ricsne2010/bobcat-dash/breakout-board/docs/mounting-template.pdf

# BREAKOUT BOARD DRILLING TEMPLATE - FULL SIZE 1:1

Print on US Letter at "Actual size" / 100 % (NOT "Fit", "Shrink oversized pages" or "Scale to fit"). Check both rulers before drilling. Board rev 3.0, 162 x 159 mm (6.378 x 6.260 in). Viewed from the FRONT (parts side): tape it to the box's back wall as you'll see the board.

## TOP OF BOX (narrow end) - top edge about 10 mm below the inside top wall

board centre

TO PI (ribbon)

TILT

COIL

TEMP
PROBE

AUX

POWER | 5V | HORN | TACH | SWITCHES | FUEL | SILENCE | LIGHTS

MONO AMP
STEREO AMP | ADC

Harness plugs (Phoenix MSTB) all along this edge: wires leave DOWNWARD, toward the deep end of the box. Top edge ~10 mm below the inside top wall leaves ~40 mm (1-1/2") below the board for plugs, wire bends and tie-downs.

H1 | H2
H3 | H4

H15

H16

H17

H18

H19 (near centre)

153.0 mm (6.024") hole centre to hole centre

137.5 mm (5.413") hole centres

159.0 mm (6.260") board height

9 holes, all M3: 4 corners, 4 near the middle of each side, 1 near the centre.
Edge holes 4.5 mm in from the top/side edges; bottom row 17 mm up from the bottom edge.
0 | 1 | 2 | 3 | 4 | 5 | 6 | 7 | 8 | 9 | 10

100 mm (10 cm): must measure exactly 100 mm

0 | 1 | 2 | 3 | 4 | 5 | 6

### 6 inches: must measure exactly 6 in

Before drilling: 1) Both rulers must measure exactly. Also check 153.0 mm between the H1 and H2 hole centres. If anything is off, reprint at Actual size.
2) Tape the sheet flat on the box's back wall, TOP toward the narrow end, centred left-right, its top edge ~10 mm below the inside top wall.
3) Centre-punch the dot in each hole. Drill 1/8" (3.2 mm) for M3 screws through the wall, or 2.5 mm to tap M3 into thick metal.
4) Mount on 9 M3 standoffs (10 mm or taller, all the same height): the board's back must not touch the box. Outer circle = ~6 mm standoff.
Grey zones: plugs and modules. The Pi ribbon plugs in on the top edge and goes straight up to the lid; COIL (high voltage) left, TILT and TEMP PROBE right.

github.com/ricsne2010/bobcat-dash - breakout-board/docs/mounting-template.pdf
