ricsne2010/bobcat-dash/breakout-board/cht-board/docs/cht-board-3d.png

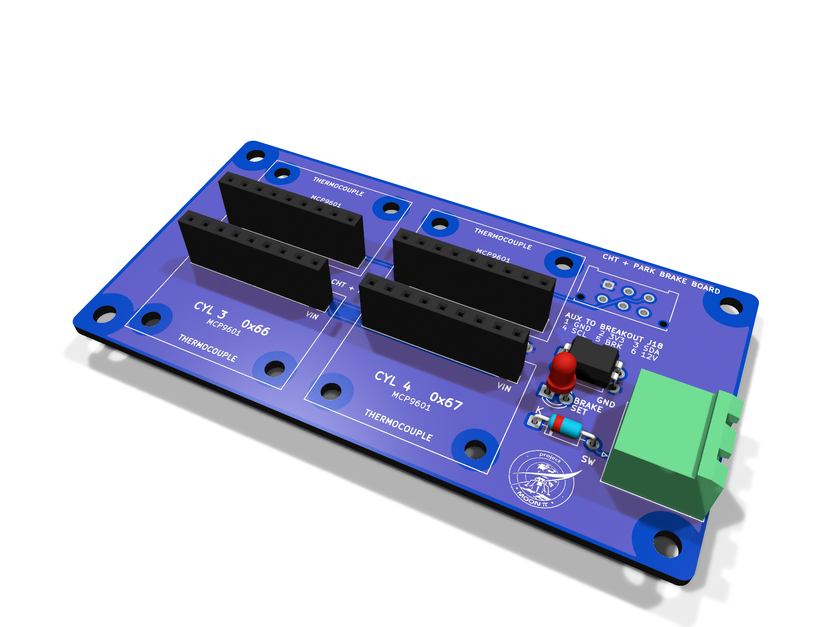
breakout-board/cht-board/docs/cht-board-3d.png
