ricsne2010/bobcat-dash/breakout-board/cht-board/docs/cht-board-bottom.png

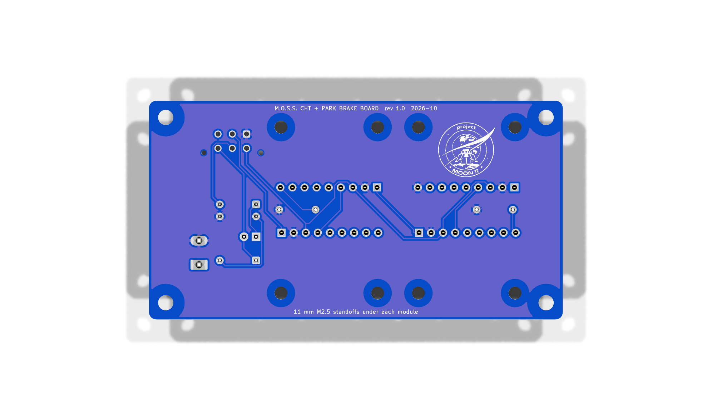
breakout-board/cht-board/docs/cht-board-bottom.png
