ricsne2010/bobcat-dash/breakout-board/docs/board-3d.png

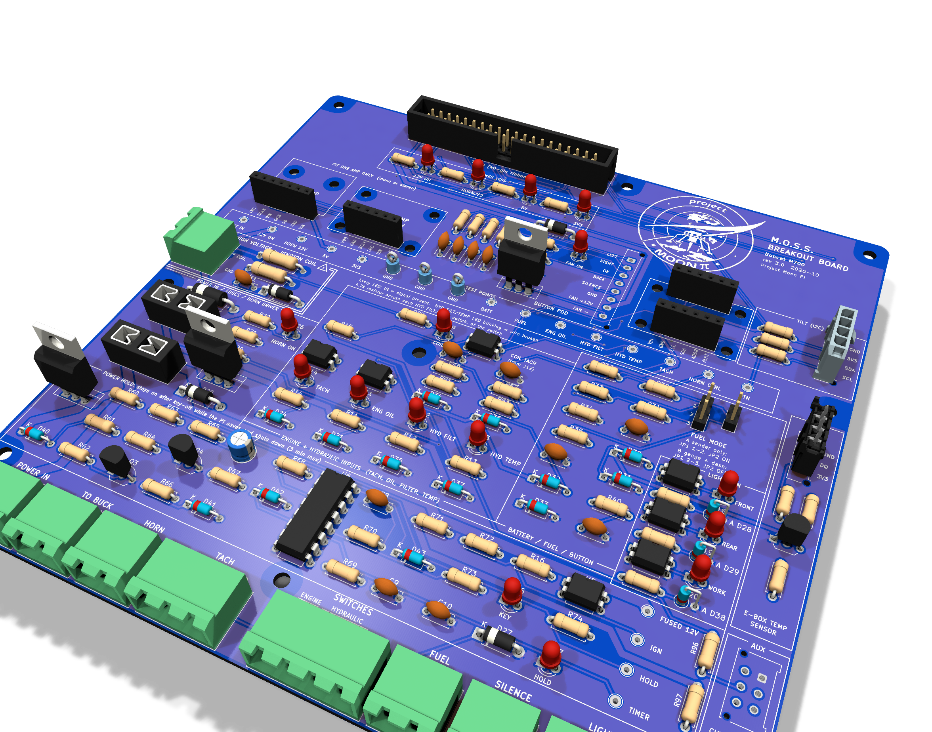
breakout-board/docs/board-3d.png
