ricsne2010/bobcat-dash/breakout-board/docs/board-bottom.png

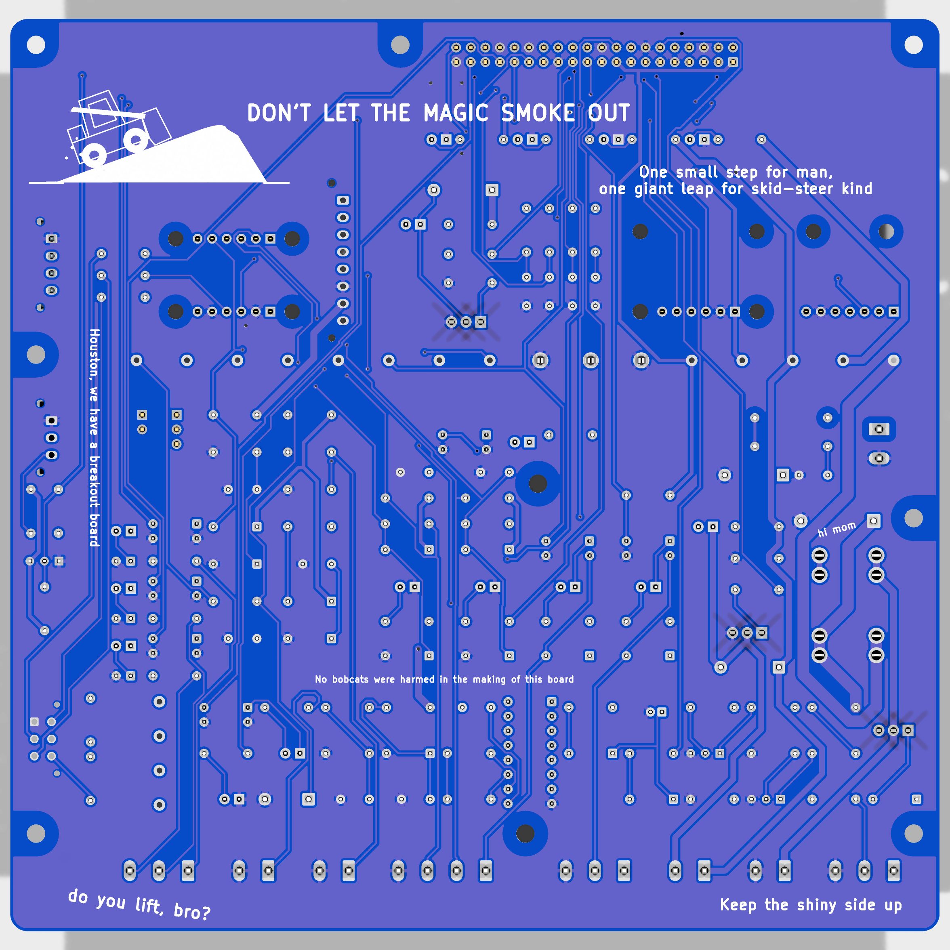
breakout-board/docs/board-bottom.png
