ricsne2010/bobcat-dash/enclosure/button-pod/concept-narrow.png

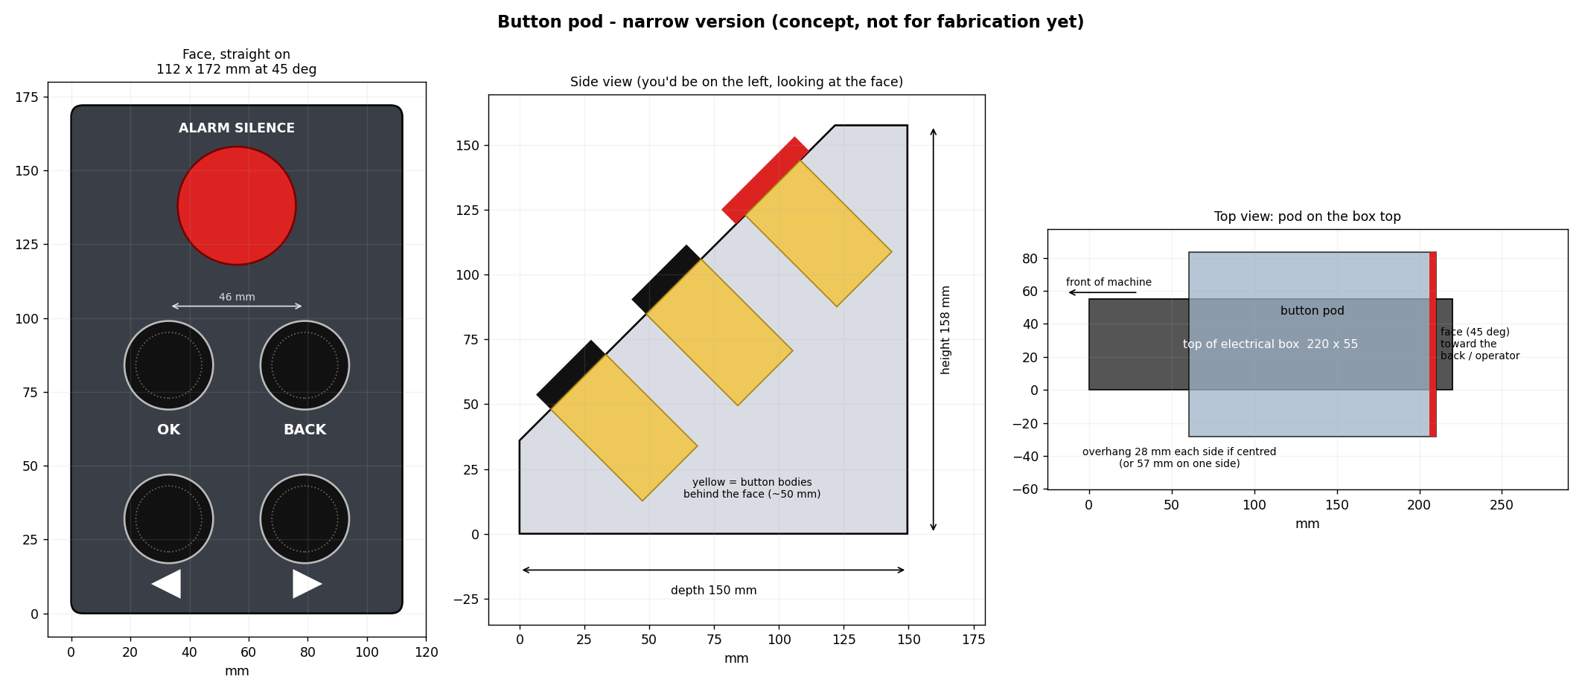
enclosure/button-pod/concept-narrow.png
