ricsne2010/bobcat-dash/enclosure/button-pod/concept.png

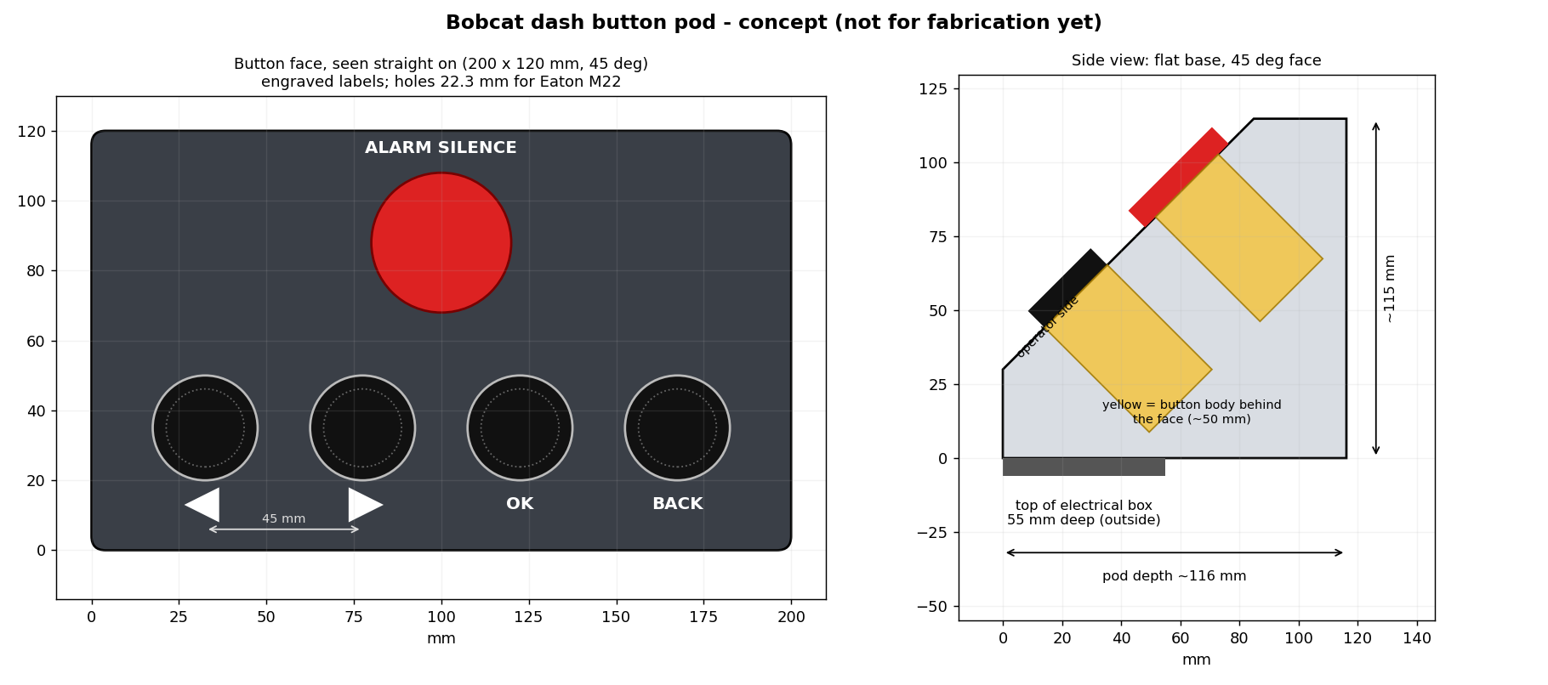
enclosure/button-pod/concept.png
