ricsne2010/bobcat-dash/enclosure/button-pod/pod-arm-section.png

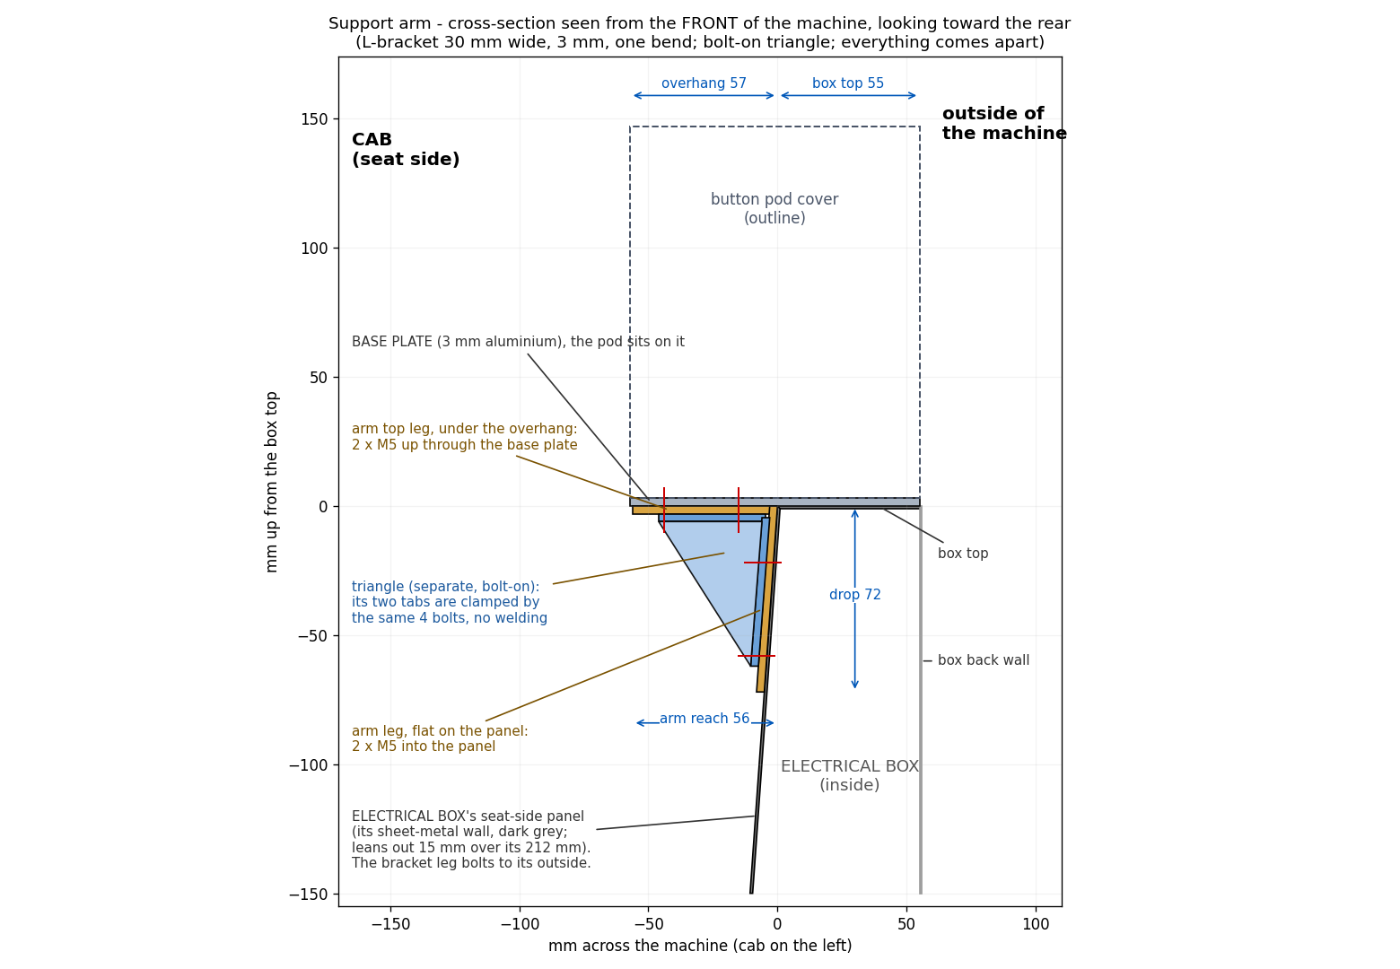
enclosure/button-pod/pod-arm-section.png
