ricsne2010/bobcat-dash/enclosure/button-pod/pod-plate-holes.png

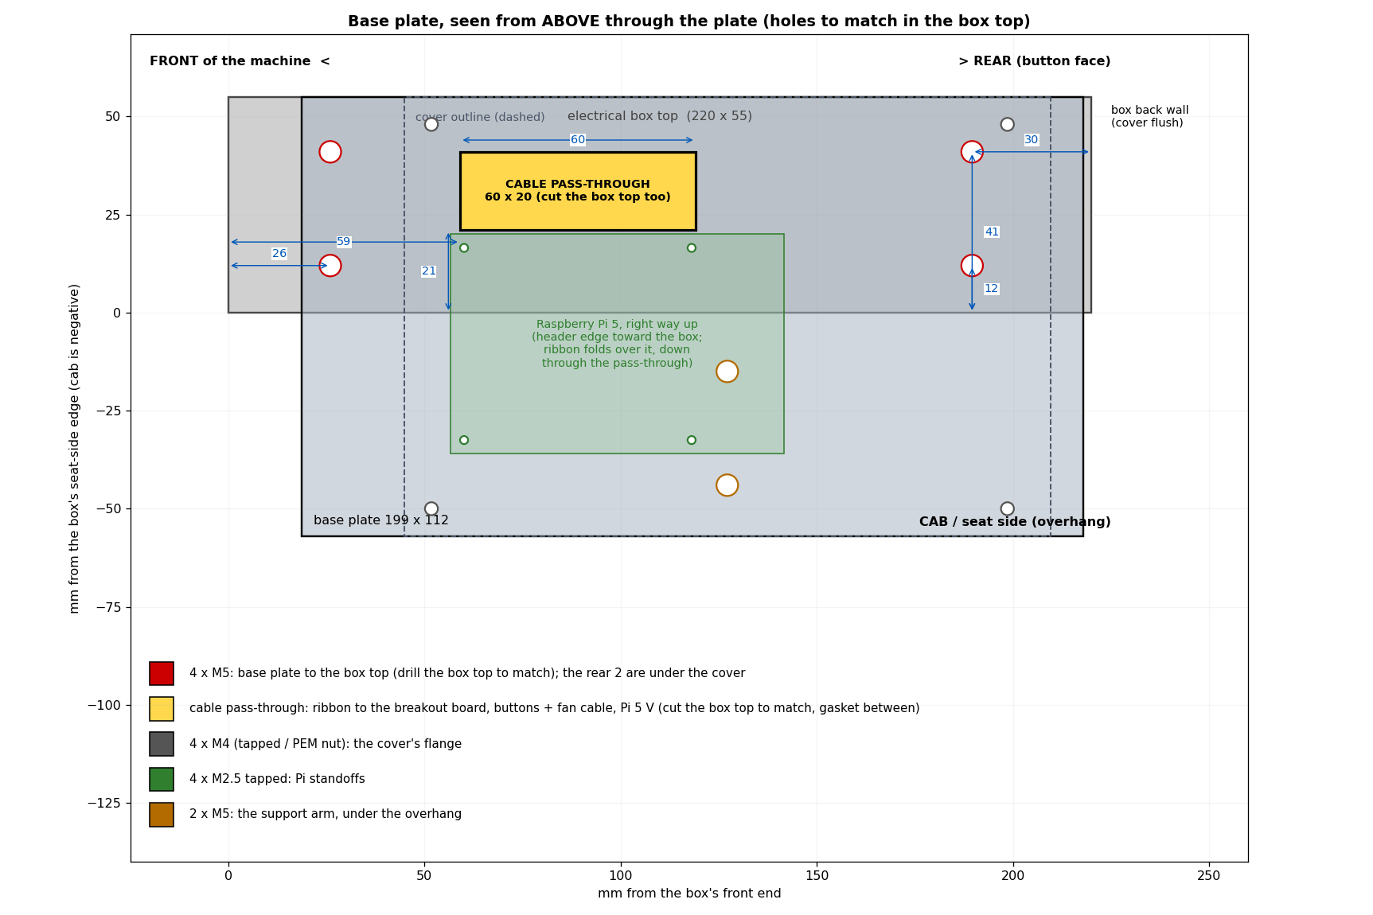
enclosure/button-pod/pod-plate-holes.png
