ricsne2010/bobcat-dash/docs/bobcat-dash-BOM.xlsx

Bobcat Digital Dash — Bill of Materials
Matches docs/wiring-schematic.jpg ("Sch. n" = schematic section) and README.md.
How to use: enter prices in the yellow cells (e.g. 4.95); extended prices and totals update automatically. Mark Ordered with Y/N.
Item | Qty | Part | Value / Spec | Example Part No. | Used In | Notes | Unit Price (USD) | Ext. Price (USD) | Supplier | Ordered
COMPUTER + DISPLAY
1 | 1 | Raspberry Pi | Pi 4 Model B (2 GB+) or Pi 5 | Raspberry Pi 4B / Pi 5 | Sch. 2 | Pi 5 needs a 5 A supply
2 | 1 | microSD card | 16–32 GB, high-endurance, A1/A2 | SanDisk High Endurance | — | Do NOT enable the overlay file system: it would erase the engine hours
3 | 1 | Pi 5 RTC battery | Rechargeable lithium-manganese coin cell, 2-pin JST-SH lead (Pi 5 only) | Raspberry Pi RTC battery (Panasonic ML-2020) | README: Screens / Dates | Plugs into the Pi 5's BAT socket; keeps the clock through key-off; setup-pi.sh turns its charging on. Never a CR2032 (not rechargeable). Rated to 60 °C
4 | 1 | Weatherproof HDMI monitor | 12 V powered, IP65+, ≥800 nits, 1024×768 or similar | — | README: Monitor | Sunlight-readable strongly recommended. Note its native resolution for the splash + video= setting
5 | 1 | HDMI cable | Micro-HDMI to HDMI, long enough to reach the monitor (≤5 m) | — | README: Monitor | Pi 4/5 use micro-HDMI. Strain-relieve both ends
6 | 1 | Inline fuse holder + fuse | Blade type, size from the monitor's manual (typ. 3–5 A) | — | README: Monitor | Key-switched 12 V feed to the monitor. Ground the monitor at the board's ground point
7 | 1 | Heatsink or fan case | For Pi 4/5 | — | — | Enclosed cab gets hot in summer
 |  |  |  |  |  | Subtotal — Computer + Display
POWER
8 | 1 | Buck converter 12 V → 5 V | 5 A, 8–36 V input, automotive | — | Sch. 1 | Not a cigarette-lighter USB plug
9 | 1 | Inline fuse holder + fuse | Blade type, 7.5 A | — | Sch. 1 | At the battery, on the constant +12 V feed to the board's BAT+ (rev 2.0). Hand-wired without the board: 3 A on the ignition feed instead
10 | 1 | Inline fuse holder + fuse | Blade type, 2 A | — | Board README | At the key switch, on the IGN sense wire to the board (rev 2.0)
11 | 1 | USB-C power lead / pigtail | Buck output to Pi | — | Sch. 1 | Or feed the Pi's 5 V header pins
 |  |  |  |  |  | Subtotal — Power
SENSOR INTERFACE
12 | 1 | ADC board | ADS1115 16-bit, 4-ch, I2C | Adafruit 1085 (STEMMA QT, two header rows) | Sch. 2–4 | Plugs straight into the board (rev 2.8). Address 0x48 (ADDR to GND)
13 | 4 | M2.5 standoff + 8 screws | 11 mm female-female, round (or 5 mm hex) | — | Board README | Screws the ADS1115 module down to the board (holes H5-H8) against vibration
14 | 2 | Optocoupler | PC817 | PC817 | Sch. 5 | Oil pressure and tach
15 | 1 | Resistor 47 kΩ | 1/4 W, 1 % | — | Sch. 3 | Battery divider top (ratio 5.7)
16 | 4 | Resistor 10 kΩ | 1/4 W, 1 % | — | Sch. 3, 5, 6 | Battery divider, filter/temp series (2), horn gate pull-down
17 | 1 | Resistor 220 Ω | 1/4 W | — | Sch. 4 | Fuel sender pull-up
18 | 2 | Resistor 2.2 kΩ | 1/4 W | — | Sch. 5 | Optocoupler LED current
19 | 3 | Resistor 4.7 kΩ | 1/4 W, 1 % | — | Sch. 5 | Tach pull-up, filter/temp pull-ups to 3.3 V
20 | 8 | Schottky diode | BAT85, DO-35 | BAT85 | Sch. 3, 4, 5 | ADC input clamps: one to 3.3 V, one to GND per input (A0-A3)
21 | 2 | Signal diode | 1N4148 | 1N4148 | Sch. 5 | Reverse protection across opto LEDs
22 | 4 | Capacitor 0.1 µF | Ceramic, 50 V | — | Sch. 3, 4, 5 | ADC input filter (A0-A3)
23 | 2 | Status LED + 470 Ω (optional) | 3 mm yellow LED, 1/4 W resistor | — | Sch. 5 note | GPIO23 / GPIO24 filter/temp LEDs: on = active, blink = wire broken
 |  |  |  |  |  | Subtotal — Sensor Interface
SENSORS
24 | 0 | Hall-effect sensor (OPTIONAL) | NPN, normally open, 6–36 V, M12 | NJK-5002C | Sch. 5 | Not needed: this machine reads RPM from the ignition coil (board COIL input, rev 2.2+). Only for the Hall option
25 | 0 | Magnet (OPTIONAL) | Neodymium, ~10 mm, + high-temp epoxy | — | Sch. 5 | Hall option only: on crank pulley; pulses_per_rev = 1
26 | 0 | Sensor bracket (OPTIONAL) | Steel, holds Hall sensor 3–8 mm from magnet | — | Sch. 5 | Hall option only
27 | 2 | End-of-line resistor 4.7 kΩ | 1/2 W metal film, 1 %, 155 °C rated | — | Sch. 5 | One across each filter / temp switch, AT the switch. Seal in adhesive-lined heat-shrink.
 |  |  |  |  |  | Subtotal — Sensors
ALARM + SOUND
28 | 1 | Piezo alarm | 12 V, 100–110 dB, IP65+, panel mount | — | Sch. 6 | The horn: mount aimed at the operator
29 | 1 | N-MOSFET, logic-level | IRLZ44N (TO-220) or AO3400 (SMD) | IRLZ44N | Sch. 6 | Or a 1-ch opto relay module instead
30 | 1 | Resistor 100 Ω | 1/4 W | — | Sch. 6 | MOSFET gate resistor
31 | 1 | Inline fuse holder + fuse | Blade type, 1 A | — | Sch. 6 | Horn circuit
32 | 1 | Push button | Momentary, panel mount, IP67 | — | Sch. 6 | Silence button, GPIO 5. Glove-friendly size
33 | 1 | I2S amplifier board | MAX98357A, 3 W, mono (or the stereo board) | Adafruit 3006 (mono, J9) or 6513 (stereo, J16) | Sch. 6 | Fit one only. dtoverlay=max98357a
34 | 4 | M2.5 standoff + 8 screws | female-female, ~11 mm, for the amp board | — | Board README | Mono uses 2 (H9-H10), stereo 4 (H11-H14)
35 | 1 | Speaker | 4 Ω, 3 W, weather-resistant | — | Sch. 6 | Startup chime + in-cab alert tones
36 | 1 | Rectifier diode (optional) | 1N4007 | 1N4007 | Sch. 6 | Only with a coil horn or relay
 |  |  |  |  |  | Subtotal — Alarm + Sound
BREAKOUT BOARD rev 2.4 (replaces the perfboard; key-off shutdown, light sensing, coil tach in its own HV corner)
37 | 1 | Bare PCB | 162 × 159 mm (rev 2.9), 2 layers, 1.6 mm, 1 oz | breakout-board/fab gerbers zip | Board README | Most board makers sell a minimum of 5. Has the Project Moon Pi logo on top
38 | 1 | Board components kit | Everything in breakout-board/fab/board-bom.csv | — | Board README | Includes the resistors, diodes, optos and MOSFET listed above, plus the power-hold parts (IRF4905, CD4060, BC547 ×2)
39 | 1 | Pluggable terminal plugs | 5.08 mm: 5× 2-pin, 3× 3-pin, 1× 4-pin | Phoenix MSTB 2,5/x-ST-5,08 | Board README | Mate with the board's MSTBA headers
40 | 1 | 40-pin IDC ribbon cable | Female–female, 15–30 cm | — | Board README | Pi GPIO to board J1, pin 1 to pin 1
41 | 1 | IC socket | DIP-16, 7.62 mm | — | Board README | Optional, for U6 (CD4060)
42 | 2 | Jumper shunt | 2.54 mm | — | Board README | JP1 / JP2 fuel mode
 |  |  |  |  |  | Subtotal — Breakout Board Rev 2.4
LIGHTS (feed + sensing): see docs/lights-wiring.jpg
43 | 1 | Automotive relay | 12 V mini ISO, 4-pin, normally open, 30/40 A, WITH suppression diode | — | docs/lights-wiring.jpg | Key ON/RUN drives the coil (86 = +, 85 = ground). Feeds the light switches
44 | 1 | Relay socket / pigtail | Weatherproof, for a 4-pin mini ISO relay | — | docs/lights-wiring.jpg | Or use a sealed fuse + relay box instead of this, the relay fuse and the two branch fuses
45 | 1 | Inline fuse holder + fuse | Blade, 15 A (size for all the lights) | — | docs/lights-wiring.jpg | Battery + to relay 30, within 18 in of the battery
46 | 1 | Inline fuse holder + fuse | Blade, 3 A | — | docs/lights-wiring.jpg | Key ON/RUN to relay 86 (coil)
47 | 2 | Inline fuse holder + fuse | Blade, FRONT 10 A and REAR/WORK 7.5 A (size to your lights) | — | docs/lights-wiring.jpg | Relay 87 to each switch. Fuse = watts ÷ 12 × 1.25
48 | 3 | Inline fuse holder + fuse | Blade, 1 A | — | docs/lights-wiring.jpg | One per sense wire (front, rear, work), at the tap on the lamp side of the switch
49 | 2 | Light switch | ≥15 A at 12 V DC, sealed: 1 × SPST on/off, 1 × SPDT ON-OFF-ON | — | docs/lights-wiring.jpg | Front on/off; back up = rear, middle = off, down = work
 |  |  |  |  |  | Subtotal — Lights
MACHINE ANGLE (roll / pitch): README, Machine angle
50 | 1 | Accelerometer + gyro board | LSM6DSOX 6-DoF, I2C, 3.3 V (or LSM6DS3TR-C, Adafruit 4503) | Adafruit 4438 | README: Machine angle | Mount rigidly to the frame, flat, X arrow forward. I2C address 0x6A
51 | 1 | Micro-Fit 3.0 receptacle housing | 4-position, single row, latching | Molex 43645-0400 | Board README: TILT | Plugs into the board's TILT header J13 (43650-0415)
52 | 4 | Micro-Fit 3.0 crimp pins | Female, 20-24 AWG | Molex 43030-0007 | Board README: TILT | Crimp tool for Micro-Fit, or buy pre-crimped Micro-Fit leads
53 | 1 | Sensor cable | 22-24 AWG, 4-core, shielded if possible, under ~30-50 cm | — | README: Machine angle | Your 14/16 AWG harness wire won't fit the Micro-Fit pins or the sensor board. Solder this end into the sensor board; shield to GND at the board end only
 |  |  |  |  |  | Subtotal — Machine Angle
TEMPERATURE: README, Temperatures
54 | 2 | Waterproof temperature probe | DS18B20 in a stainless tip, 3-wire cable (red 3V3, black GND, yellow/white data) | — | README: Temperatures | One for the cab, one for outside air (shade it from sun and engine heat). Optional: the board measures the box itself
55 | 1 | Micro-Fit 3.0 receptacle housing | 3-position, single row, latching | Molex 43645-0300 | Board README: TEMP PROBE | Plugs into the board's TEMP PROBE header J14 (43650-0315)
56 | 3 | Micro-Fit 3.0 crimp pins | Female, 20-24 AWG | Molex 43030-0007 | Board README: TEMP PROBE | Two probes: join their 3 wires in the cable (each wire to the same pin)
57 | 1 | Micro-Fit 3.0 receptacle housing | 8-position, single row, latching | Molex 43645-0800 | Board README: BUTTON POD | Plugs into the board's POD header J17 (43650-0815)
58 | 8 | Micro-Fit 3.0 crimp pins | Female, 20-24 AWG | Molex 43030-0007 | Board README: BUTTON POD | 8-core cable, board to the pod (buttons, SILENCE, GND, fan)
59 | 4 | Pushbutton head, black | Eaton M22, 22 mm, momentary | Eaton M22-D-S (flat-style head) | enclosure/button-pod | LEFT, RIGHT, OK, BACK
60 | 1 | Pushbutton head, red mushroom | Eaton M22, 22 mm, momentary | Eaton M22-DP-R | enclosure/button-pod | ALARM SILENCE
61 | 5 | Fixing adapter | Eaton M22 | Eaton M22-A | enclosure/button-pod | One per button
62 | 5 | Contact block, 1 NO | Eaton M22 | Eaton M22-K10 | enclosure/button-pod | One per button
63 | 1 | Exhaust fan | 40 x 40 x 10 mm, 12 V | any (two-wire) | enclosure/button-pod | Back wall of the pod; switched by the board (Q5)
64 | 1 | Cable gland | M20, for the HDMI cable | nylon or nickel-brass | enclosure/button-pod | Back wall of the pod
 |  |  |  |  |  | Subtotal — Temperature: Readme, Temperatures
CYLINDER HEAD TEMPS + PARKING BRAKE (breakout board rev 3.0 AUX, breakout-board/cht-board): README, CHT / Parking brake
65 | 1 | CHT + Parking Brake board | 87 x 46 mm, blue, 2 layers | PCBWay, breakout-board/cht-board/fab/cht-board-gerbers.zip | cht-board README | Parts on the board: cht-board/fab/cht-board-bom.csv (sockets, PC817, LED, 1N4148, 22k, 43k, Micro-Fit, Phoenix)
66 | 1 | CHT thermocouple | Type K, ungrounded, 18 mm ring, flexible stem, male mini K plug | The Sensor Connection CHT-FS-072-06-18-K-MP (or -120- / custom 144 in) | README: CHT | One per cylinder (start with one). Under the spark plug, ring for 18 mm plugs (Champion D-16J)
67 | 1 | Thermocouple amplifier module | MCP9601, I2C, Type K, cold-junction compensated | Adafruit 5165 | cht-board README | One per thermocouple, in the CHT board's socket for that cylinder; leave its address jumpers open
68 | 1 | Type K extension wire | KX, 20-24 AWG, FEP or fibreglass, stainless braid near the exhaust | Omega EXTT-K-24 or similar | README: CHT | Length to reach the e-box. Never plain copper wire
69 | 1 | Mini Type K connector pair | Female jack + male plug, Type K alloy contacts (yellow) | Omega SMPW-K-F + SMPW-K-M or similar | README: CHT | Extension ends; or a panel-mount mini K jack on the e-box wall
70 | 4 | M2.5 standoff + screws | 11 mm, brass | — | cht-board README | Two per MCP9601 module
71 | 1 | Micro-Fit 3.0 dual-row housings (pair) | 2 x 3, latching | Molex 43025-0600 (x2) | cht-board README | AUX cable: breakout board J18 to CHT board J1, pin 1 to pin 1
72 | 12 | Micro-Fit 3.0 crimp pins | Female, 20-24 AWG | Molex 43030-0007 | cht-board README | AUX cable, both ends
73 | 1 | Parking brake switch | Sealed (IP67) roller-lever microswitch, closes when the brake is set, factory pigtail | e.g. Honeywell V15W series or similar | README: Parking brake | Mount on the handle; Deutsch DT 2-pin at the handle; to the CHT board's PARK BRAKE plug
 |  |  |  |  |  | Subtotal — Cylinder Head Temps + Parking Brake
CHARGING: Delco 10SI 3-wire alternator (docs/wiring-schematic.jpg, section 7)
74 | 1 | Rectifier diode | 1N4001, 1 A 50 V | 1N4001 | Sch. 7 | In the terminal 1 (excite) wire, band toward the alternator: stops the running alternator back-feeding the key circuit (engine run-on, dash never sees key-off)
75 | 1 | Resistor 47 Ω | 5 W wirewound | — | Sch. 7 | In series with the diode: ~0.25 A with the key on and the engine stopped, like the charge lamp it replaces. Use the alternator maker's value if they give one
76 | 1 | Fusible link or circuit breaker | Rated for the alternator (e.g. 60 A) | — | Sch. 7 | On the BAT stud wire, near the battery end. 8 AWG wire (10 AWG for 45 A units)
 |  |  |  |  |  | Subtotal — Charging: Delco 10Si 3-Wire Alternator
WIRING + ENCLOSURE
77 | 1 | Enclosure | IP65+, fits Pi + interface boards | — | — | Vibration-mount it
78 | 1 | Prototype board | Perfboard / stripboard | — | — | Only if hand-wiring instead of the breakout board
79 | 1 | Automotive wire | 18 AWG TXL/GXL, several colors | — | — | Lot
80 | 1 | Sealed connectors | Deutsch DT or Weatherpack assortment | — | — | Avoid loose Dupont jumpers on the machine
81 | 1 | Screw terminal blocks | PCB 5 mm pitch assortment | — | — | Field wiring into the enclosure
82 | 1 | Heat-shrink + terminals | Assortment | — | — | Lot
83 | 1 | Display mount | RAM-style ball mount or bracket | — | — | With vibration damping
84 | 1 | Standoffs | M2.5 nylon/brass set | — | — | Mount the Pi and the plug-in modules
85 | 9 | M3 standoff + screws | 10 mm or taller, all the same height | — | Board README | Breakout board mounting: 4 corners, 4 mid-sides, 1 centre (drilling template)
 |  |  |  |  |  | Subtotal — Wiring + Enclosure
EXISTING MACHINE PARTS (reuse, check they work)
86 | 1 | Oil pressure switch | Original, closes on low pressure | — | Sch. 5 | GPIO 22 via optocoupler
87 | 1 | Hydraulic filter bypass switch | Original, closes on bypass | — | Sch. 5 | ADS1115 A2, monitored (4.7k EOL resistor at the switch)
88 | 1 | Hydraulic oil temp switch | Original, closes when hot | — | Sch. 5 | ADS1115 A3, monitored (4.7k EOL resistor at the switch)
89 | 1 | Fuel sender | Original, in tank | — | Sch. 4 | Calibrate with dash.py --calibrate
 |  |  |  |  |  | Subtotal — Existing Machine Parts
 |  |  |  |  |  | TOTAL (all sections)
 |  |  |  |  |  | Items still to order (excl. existing parts)
Notes: Qty in blue = quantity per machine. Existing machine parts usually cost $0 unless one needs replacing. Prices are left blank on purpose. Enter what you actually pay.
