ricsne2010/bobcat-dash/breakout-board/fab/board-bom.csv

Refs | Value | Footprint | Qty | Description
C1,C2,C3,C4,C5,C9,C10,C12,C13,C14,C15 | 100nF | Capacitor_THT:C_Disc_D5.0mm_W2.5mm_P5.00mm | 11 | BACK button: debounce / noise filter,Debounce / noise filter,Decoupling,Filter,LEFT button: debounce / noise filter,OK button: debounce / noise filter,RIGHT button: debounce / noise filter
C7 | 10uF 25V | Capacitor_THT:CP_Radial_D5.0mm_P2.00mm | 1 | Stretches a power cut to a few seconds
C8 | 100nF film | Capacitor_THT:C_Disc_D5.0mm_W2.5mm_P5.00mm | 1 | Timing capacitor (film for accuracy)
C11 | 1uF 50V | Capacitor_THT:C_Disc_D5.0mm_W2.5mm_P5.00mm | 1 | Filters the coil's ringing: one clean pulse per spark (ceramic, X7R)
D1 | P6KE20A | Diode_THT:D_DO-15_P12.70mm_Horizontal | 1 | TVS: clamps spikes, blows F1 if wired backwards
D2,D3,D4,D5,D17,D47 | LED_green | LED_THT:LED_D3.0mm | 6 | +3.3V from Pi present,+5V from Pi present,Board powered (+12V switched on),Horn feed present (F2 OK),Pi is holding power on,Pod fan ON
D11,D12,D13,D14,D16,D18,D19,D20,D39 | LED_yellow | LED_THT:LED_D3.0mm | 9 | Coil input: on while the coil is not charging, flickers with the engine,FILT: on = active, blink = wire fault (driven by the Pi),Front light on,Key on,OIL input active,Rear light on,TACH input active,TEMP: on = active, blink = wire fault (driven by the Pi),Work light on
D21,D24,D41,D42 | 1N4148 | Diode_THT:D_DO-35_SOD27_P7.62mm_Horizontal | 4 | Pi KILL -> power cut,Reverse-spike protection across the LEDs,Timer -> power cut
D25,D46 | 1N4007 | Diode_THT:D_DO-41_SOD81_P10.16mm_Horizontal | 2 | Flyback (coil horn / relay),Flyback (fan motor)
D26 | LED_red | LED_THT:LED_D3.0mm | 1 | Horn output ON
D27 | 1N4007 | Diode_THT:D_DO-41_SOD81_P7.62mm_Horizontal | 1 | Clamps negative spikes on the IGN wire
D28,D29,D38 | 1N4148 | Diode_THT:D_DO-35_SOD27_P2.54mm_Vertical_AnodeUp | 3 | Reverse-spike protection across the LEDs (standing diode)
D30,D31,D32,D33,D34,D35,D36,D37 | BAT85 | Diode_THT:D_DO-35_SOD27_P7.62mm_Horizontal | 8 | Schottky clamp to 3.3V,Schottky clamp to GND
D40 | BZX79C15 | Diode_THT:D_DO-35_SOD27_P7.62mm_Horizontal | 1 | 15 V zener: limits gate-source voltage
D43 | BZX79C10 | Diode_THT:D_DO-35_SOD27_P7.62mm_Horizontal | 1 | 10 V supply for U6
D45 | 1N4744A | Diode_THT:D_DO-41_SOD81_P10.16mm_Horizontal | 1 | 15 V 1 W zener: clamps the coil spike (and negative ringing to -0.7 V)
F1 | 5A | Fuse:Fuseholder_Blade_Mini_Keystone_3568 | 1 | Mini blade fuse: main feed
F2 | 1A | Fuse:Fuseholder_Blade_Mini_Keystone_3568 | 1 | Mini blade fuse: horn
J1 | TO PI (40-pin ribbon) | Connector_IDC:IDC-Header_2x20_P2.54mm_Vertical | 1 | Box header, straight 40-pin IDC ribbon to the Pi GPIO header
J2 | POWER IN | Connector_Phoenix_MSTB:PhoenixContact_MSTBA_2,5_3-G-5,08_1x03_P5.08mm_Horizontal | 1 | Constant battery +12V (fused at the battery), key switch IGN signal, chassis ground
J3 | TO 5V BUCK | Connector_Phoenix_MSTB:PhoenixContact_MSTBA_2,5_2-G-5,08_1x02_P5.08mm_Horizontal | 1 | Switched, fused +12V out to the 12V->5V buck
J4 | SWITCHES | Connector_Phoenix_MSTB:PhoenixContact_MSTBA_2,5_4-G-5,08_1x04_P5.08mm_Horizontal | 1 | Engine oil pressure, hydraulic filter bypass, hydraulic oil temp switch wires
J5 | TACH | Connector_Phoenix_MSTB:PhoenixContact_MSTBA_2,5_3-G-5,08_1x03_P5.08mm_Horizontal | 1 | Hall sensor (brown +12V, black SIG, blue GND), if used instead of the coil input
J6 | FUEL | Connector_Phoenix_MSTB:PhoenixContact_MSTBA_2,5_2-G-5,08_1x02_P5.08mm_Horizontal | 1 | Fuel sender
J7 | HORN | Connector_Phoenix_MSTB:PhoenixContact_MSTBA_2,5_2-G-5,08_1x02_P5.08mm_Horizontal | 1 | Piezo alarm + and -
J8 | SILENCE | Connector_Phoenix_MSTB:PhoenixContact_MSTBA_2,5_2-G-5,08_1x02_P5.08mm_Horizontal | 1 | Silence push button
J9 | MAX98357A MONO | Connector_PinSocket_2.54mm:PinSocket_1x07_P2.54mm_Vertical | 1 | Socket for the mono MAX98357A I2S amp board (Adafruit 3006): LRC BCLK DIN GAIN SD GND VIN
J10 | ADS1115 PWR/I2C | Connector_PinSocket_2.54mm:PinSocket_1x06_P2.54mm_Vertical | 1 | Socket for the ADS1115 board's bottom row: VIN GND SCL SDA ADDR ALRT (ADDR to GND: address 0x48)
J11 | LIGHTS | Connector_Phoenix_MSTB:PhoenixContact_MSTBA_2,5_3-G-5,08_1x03_P5.08mm_Horizontal | 1 | Sense wires from the lamp side of the front / rear / work light switches (a few mA each)
J12 | COIL | Connector_Phoenix_MSTB:PhoenixContact_MSTBA_2,5_2-G-5,08_1x02_P5.08mm_Horizontal | 1 | Ignition coil NEGATIVE terminal (high voltage spikes) + GND for a shielded wire's drain (rev 2.4)
J13 | TILT | Connector_Molex:Molex_Micro-Fit_3.0_43650-0415_1x04_P3.00mm_Vertical | 1 | Molex Micro-Fit 3.0 43650-0415 (latching). Mates with housing 43645-0400 + 43030-0007 pins. Tilt sensor: GND, 3V3, SDA, SCL; cable under ~30-50 cm
J14 | TEMP PROBE | Connector_Molex:Molex_Micro-Fit_3.0_43650-0315_1x03_P3.00mm_Vertical | 1 | Molex Micro-Fit 3.0 43650-0315 (latching): external DS18B20 probes: 1 GND, 2 DQ, 3 3V3. Housing 43645-0300
J15 | ADS1115 INPUTS | Connector_PinSocket_2.54mm:PinSocket_1x06_P2.54mm_Vertical | 1 | Socket for the ADS1115 board's top row: A+ A3 A2 A1 A0 A-
J16 | MAX98357A STEREO | Connector_PinSocket_2.54mm:PinSocket_1x06_P2.54mm_Vertical | 1 | Socket for the stereo MAX98357A amp board (Adafruit 6513): VDD GND BCLK LRC DIN GAIN. Fit J9 or J16, not both
J17 | POD | Connector_Molex:Molex_Micro-Fit_3.0_43650-0815_1x08_P3.00mm_Vertical | 1 | Latching Molex Micro-Fit 3.0 8-pin to the button pod: LEFT RIGHT OK BACK SILENCE GND FAN+ FAN-
J18 | AUX (CHT + BRAKE) | Connector_Molex:Molex_Micro-Fit_3.0_43045-0612_2x03_P3.00mm_Vertical | 1 | Molex Micro-Fit 3.0 43045-0612 2x3 (latching): CHT board. 1 GND, 2 3V3, 3 SDA, 4 SCL, 5 BRAKE, 6 BRAKE 12V. Housing 43025-0600
JP1 | A=1-2 B=2-3 | Connector_PinHeader_2.54mm:PinHeader_1x03_P2.54mm_Vertical | 1 | Fuel mode select
JP2 | PULL-UP (A only) | Connector_PinHeader_2.54mm:PinHeader_1x02_P2.54mm_Vertical | 1 | Fit for option A
Q1,Q5 | IRLZ44N | Package_TO_SOT_THT:TO-220-3_Vertical | 2 | Logic-level MOSFET, low-side switch,Logic-level MOSFET: pod fan, low-side switch
Q2 | IRF4905 | Package_TO_SOT_THT:TO-220-3_Vertical | 1 | P-MOSFET high-side power switch, -55 V 74 A 20 mOhm
Q3,Q4 | BC547B | Package_TO_SOT_THT:TO-92_Inline_Wide | 2 | Power cut: overrides key and HOLD,Turns Q2 on
R1,R2,R22,R95 | 3.3k | Resistor_THT:R_Axial_DIN0207_L6.3mm_D2.5mm_P7.62mm_Horizontal | 4
R3,R35,R40,R67,R68,R89,R90,R91,R92,R96 | 1k | Resistor_THT:R_Axial_DIN0207_L6.3mm_D2.5mm_P7.62mm_Horizontal | 10 | BACK button: series protection,LEFT button: series protection,OK button: series protection,Parking brake signal: series protection (GPIO 9),RIGHT button: series protection,Series,Series protection
R4,R12,R13,R71,R74,R82 | 470 | Resistor_THT:R_Axial_DIN0207_L6.3mm_D2.5mm_P7.62mm_Horizontal | 6 | LED current,LED current, ~2 mA,Status LED current,Supply
R11,R14,R16,R17,R18,R19,R97 | 2.2k | Resistor_THT:R_Axial_DIN0207_L6.3mm_D2.5mm_P7.62mm_Horizontal | 7 | LED current, ~4 mA,Parking brake input LEDs on the CHT board, ~4 mA; a shorted cable draws ~5 mA
R15,R21,R31,R34,R51,R53,R63,R72,R94 | 10k | Resistor_THT:R_Axial_DIN0207_L6.3mm_D2.5mm_P7.62mm_Horizontal | 9 | Divider bottom,Divider bottom (option B),Keeps the fan off while the Pi boots,Key on -> timer reset,Pi HOLD -> power on,Pull-down: horn off while the Pi boots,Series protection,Tach pull-up (10k from rev 2.4: halves the current the PC817s must sink, for margin at low LED current)
R20,R83,R84,R87,R93 | 100 | Resistor_THT:R_Axial_DIN0207_L6.3mm_D2.5mm_P7.62mm_Horizontal | 5 | Gate resistor,Probe data series protection,SCL series protection,SDA series protection
R30,R33,R60,R62 | 47k | Resistor_THT:R_Axial_DIN0207_L6.3mm_D2.5mm_P7.62mm_Horizontal | 4 | Divider top (option B),Divider top (ratio 5.7),Gate pull-up: Q2 off by default,Key on -> power on
R32 | 220 | Resistor_THT:R_Axial_DIN0207_L6.3mm_D2.5mm_P7.62mm_Horizontal | 1 | Sender pull-up (option A)
R50,R52,R61,R86 | 4.7k | Resistor_THT:R_Axial_DIN0207_L6.3mm_D2.5mm_P7.62mm_Horizontal | 4 | 1-Wire pull-up,Gate drive (Vgs ~ -11 V),Pull-up (pairs with the 4.7k at the switch)
R64,R65,R70,R73 | 100k | Resistor_THT:R_Axial_DIN0207_L6.3mm_D2.5mm_P7.62mm_Horizontal | 4 | Pull-down,Q4 base (~20 uA: saturates Q4 with margin),Timing resistor
R66 | 1M | Resistor_THT:R_Axial_DIN0207_L6.3mm_D2.5mm_P7.62mm_Horizontal | 1 | Discharge
R69 | 220k | Resistor_THT:R_Axial_DIN0207_L6.3mm_D2.5mm_P7.62mm_Horizontal | 1 | Oscillator input resistor
R80,R81 | 2.2k 1/2W | Resistor_THT:R_Axial_DIN0309_L9.0mm_D3.2mm_P12.70mm_Horizontal | 2 | Coil input, first half (metal film, 350 V rated),Coil input, second half
R85,R88 | 47 | Resistor_THT:R_Axial_DIN0207_L6.3mm_D2.5mm_P7.62mm_Horizontal | 2 | Probe supply: limits a shorted probe cable,Sensor supply: limits a shorted cable to ~70 mA
TP6,TP7,TP8 | GND | TestPoint:TestPoint_Keystone_5005-5009_Compact | 3 | test point
U1,U4,U5,U7,U8,U9,U10 | PC817 | Package_DIP:DIP-4_W7.62mm | 7 | Optocoupler,Optocoupler: coil tach input,Optocoupler: front light sense,Optocoupler: key sense,Optocoupler: rear light sense,Optocoupler: work light sense
U6 | CD4060BE | Package_DIP:DIP-16_W7.62mm | 1 | Key-off watchdog timer: cuts power ~3 min after key-off if the Pi hasn't
U11 | DS18B20 | Package_TO_SOT_THT:TO-92_Inline_Wide | 1 | E-BOX TEMP SENSOR: electronics box air temperature (1-Wire)
