ricsne2010/bobcat-dash/breakout-board/cht-board/fab/cht-board-bom.csv

Refs | Value | Footprint | Qty | Description
D1 | LED_green | LED_THT:LED_D3.0mm | 1 | BRAKE SET: lit while the brake is set
D2 | 1N4148 | Diode_THT:D_DO-35_SOD27_P7.62mm_Horizontal | 1 | Reverse-spike protection across the LEDs
J1 | AUX TO BREAKOUT J18 | Connector_Molex:Molex_Micro-Fit_3.0_43045-0612_2x03_P3.00mm_Vertical | 1 | Molex Micro-Fit 3.0 43045-0612 2x3 (latching): to the breakout board's AUX plug J18, pin to pin. 1 GND, 2 3V3, 3 SDA, 4 SCL, 5 BRAKE (GPIO 9), 6 BRAKE 12V. Housing 43025-0600 both ends
J2 | PARK BRAKE | Connector_Phoenix_MSTB:PhoenixContact_MSTBA_2,5_2-G-5,08_1x02_P5.08mm_Horizontal | 1 | Phoenix MSTB 2-pin: parking brake switch (closed = brake set) between SW and GND
M1 | CYL 1 MCP9601 | Connector_PinSocket_2.54mm:PinSocket_1x09_P2.54mm_Vertical | 1 | Socket for an Adafruit MCP9601 module (5165): cylinder 1, I2C 0x60. VIN GND SCL SDA ALERT1-4 ADDR
M2 | CYL 2 MCP9601 | Connector_PinSocket_2.54mm:PinSocket_1x09_P2.54mm_Vertical | 1 | Socket for an Adafruit MCP9601 module (5165): cylinder 2, I2C 0x65. VIN GND SCL SDA ALERT1-4 ADDR
M3 | CYL 3 MCP9601 | Connector_PinSocket_2.54mm:PinSocket_1x09_P2.54mm_Vertical | 1 | Socket for an Adafruit MCP9601 module (5165): cylinder 3, I2C 0x66. VIN GND SCL SDA ALERT1-4 ADDR
M4 | CYL 4 MCP9601 | Connector_PinSocket_2.54mm:PinSocket_1x09_P2.54mm_Vertical | 1 | Socket for an Adafruit MCP9601 module (5165): cylinder 4, I2C 0x67. VIN GND SCL SDA ALERT1-4 ADDR
R1 | 22k | Resistor_THT:R_Axial_DIN0207_L6.3mm_D2.5mm_P7.62mm_Horizontal | 1 | Socket 2 address: 0x65
R2 | 43k | Resistor_THT:R_Axial_DIN0207_L6.3mm_D2.5mm_P7.62mm_Horizontal | 1 | Socket 3 address: 0x66
U1 | PC817 | Package_DIP:DIP-4_W7.62mm | 1 | Optocoupler: parking brake input
