ricsne2010/bobcat-dash/enclosure/button-pod/pod-assembly.step

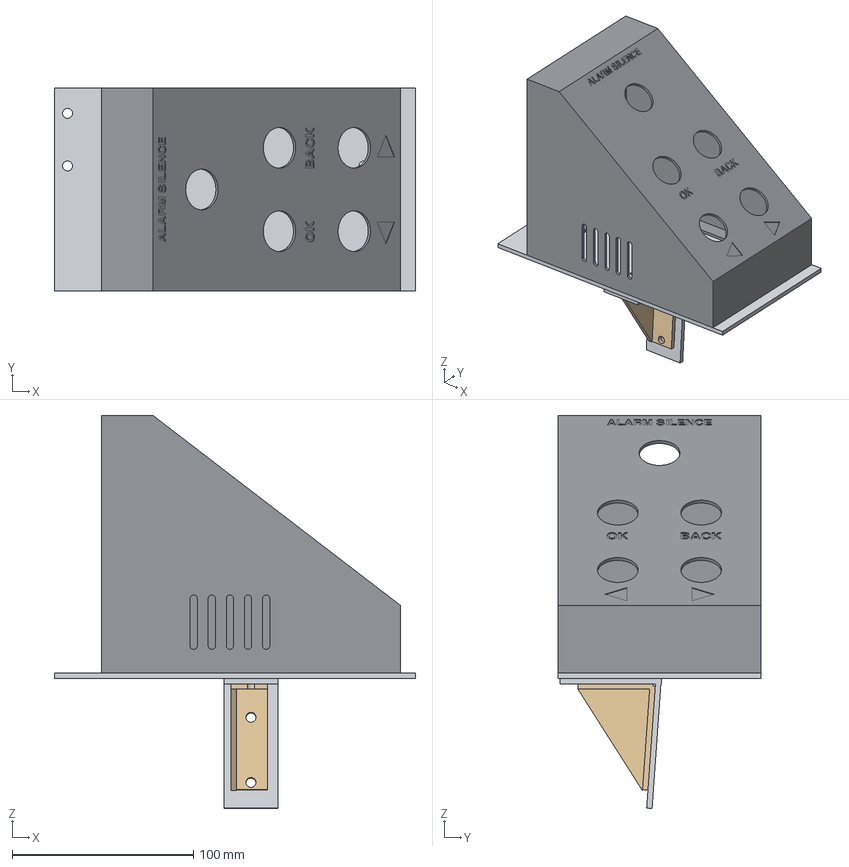
[picture p16: CAD file, 2026-10-24]
enclosure/button-pod/pod-assembly.step
199.2 x 112.0 x 216.8 mm
cover
base
arm
gusset
