ricsne2010/bobcat-dash/enclosure/button-pod/pod-gusset.step

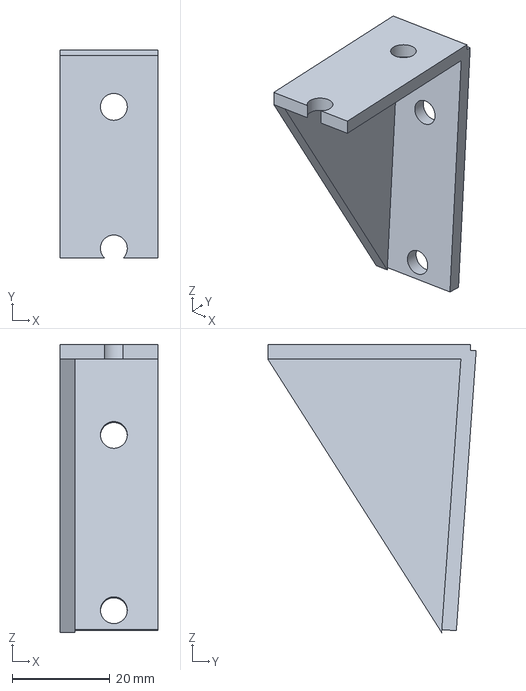
[picture p17: CAD file, 2026-10-24]
enclosure/button-pod/pod-gusset.step
20.0 x 42.7 x 59.0 mm
