ricsne2010/bobcat-dash/enclosure/button-pod/pod-cover-own-frame.step

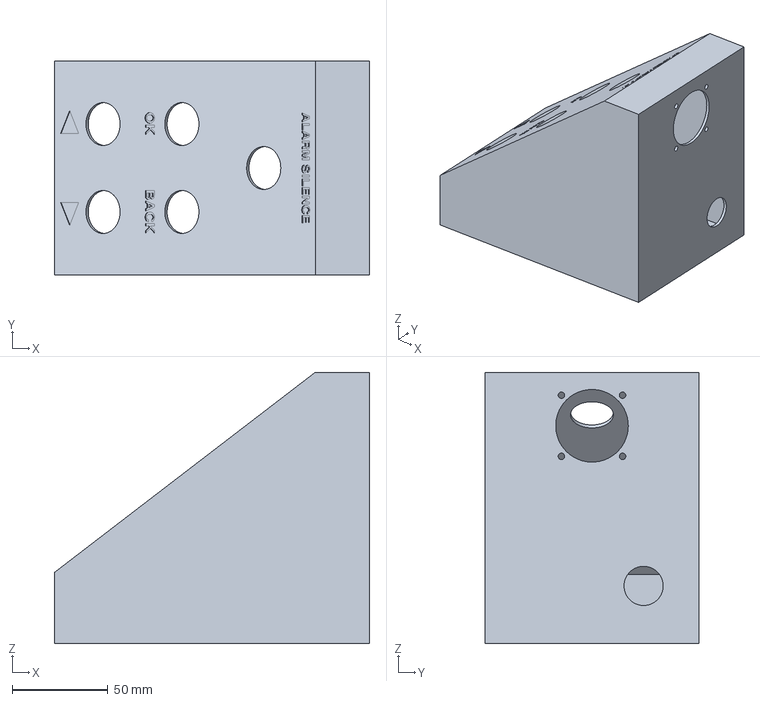
[picture p18: CAD file, 2026-10-24]
enclosure/button-pod/pod-cover-own-frame.step
164.8 x 112.0 x 142.0 mm
