ricsne2010/bobcat-dash/enclosure/button-pod/pod-arm.step

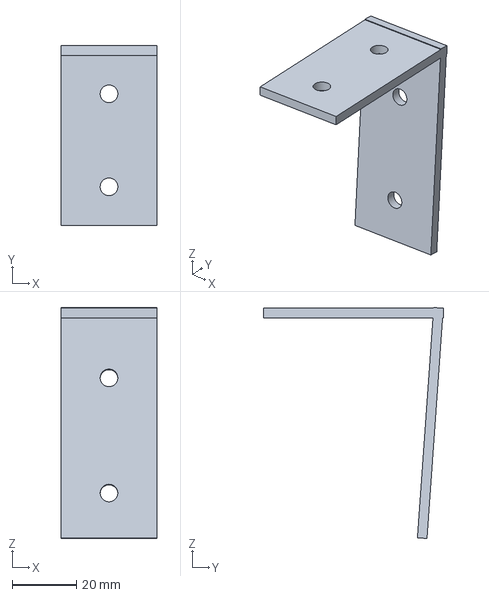
[picture p19: CAD file, 2026-10-24]
enclosure/button-pod/pod-arm.step
30.0 x 56.0 x 72.0 mm
