ricsne2010/bobcat-dash/enclosure/button-pod/pod-base.step

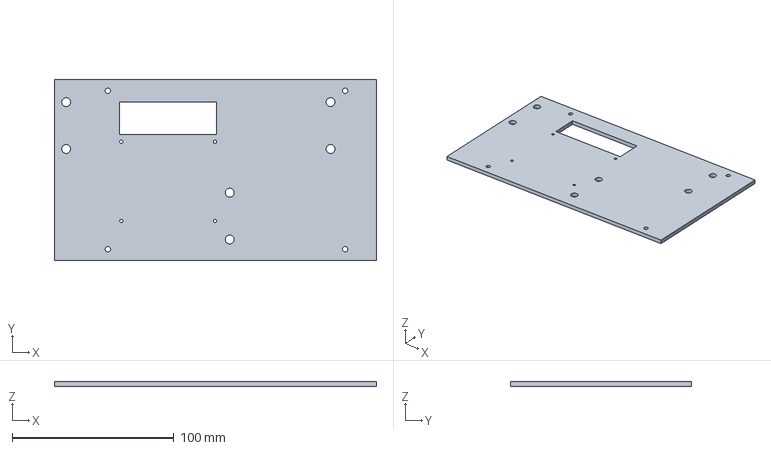
[picture p20: CAD file, 2026-10-24]
enclosure/button-pod/pod-base.step
199.2 x 112.0 x 3.00 mm
