ricsne2010/bobcat-dash/(list of files, cad)

Other CAD files:
enclosure/button-pod/pod-cover.step
enclosure/button-pod/pod-arm.stl
enclosure/button-pod/pod-base.stl
enclosure/button-pod/pod-cover.stl
enclosure/button-pod/pod-gusset.stl
