ricsne2010/bobcat-dash/docs/wiring-schematic.jpg

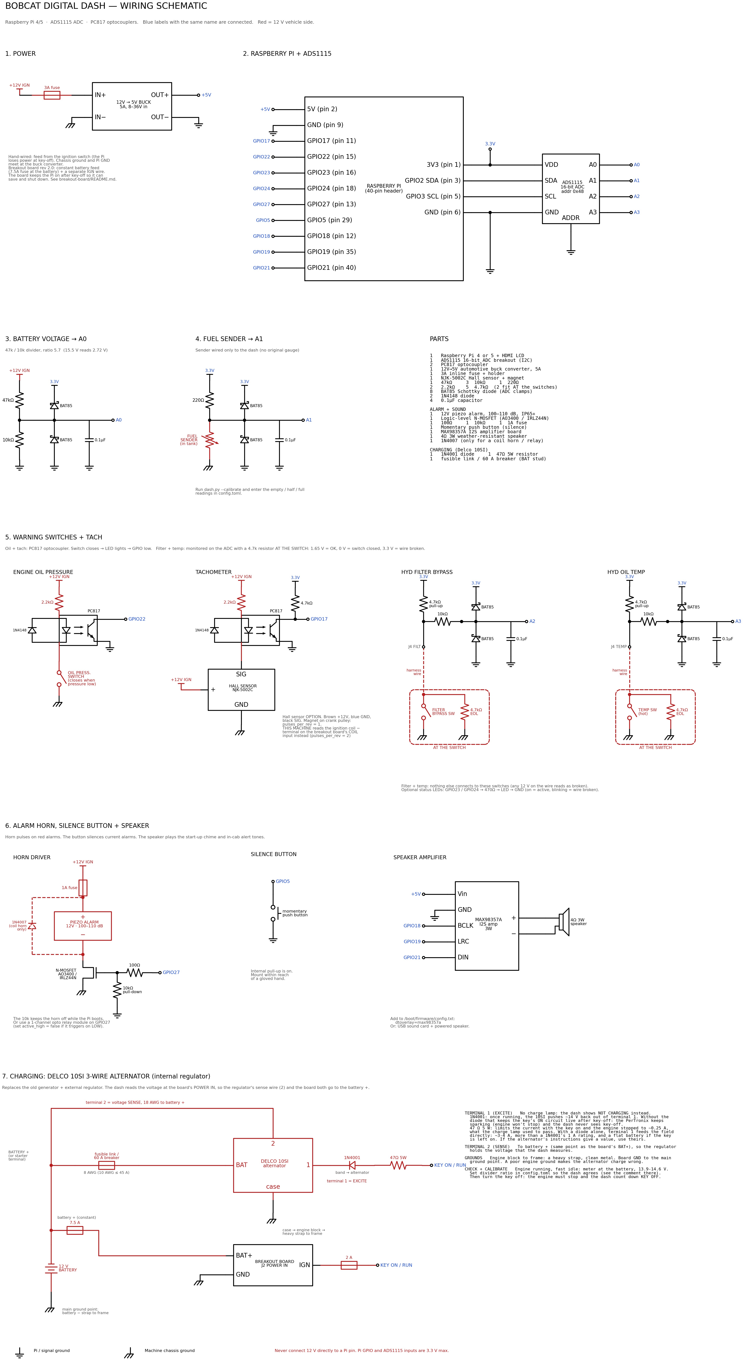
docs/wiring-schematic.jpg
