ricsne2010/bobcat-dash/breakout-board/docs/schematic.pdf

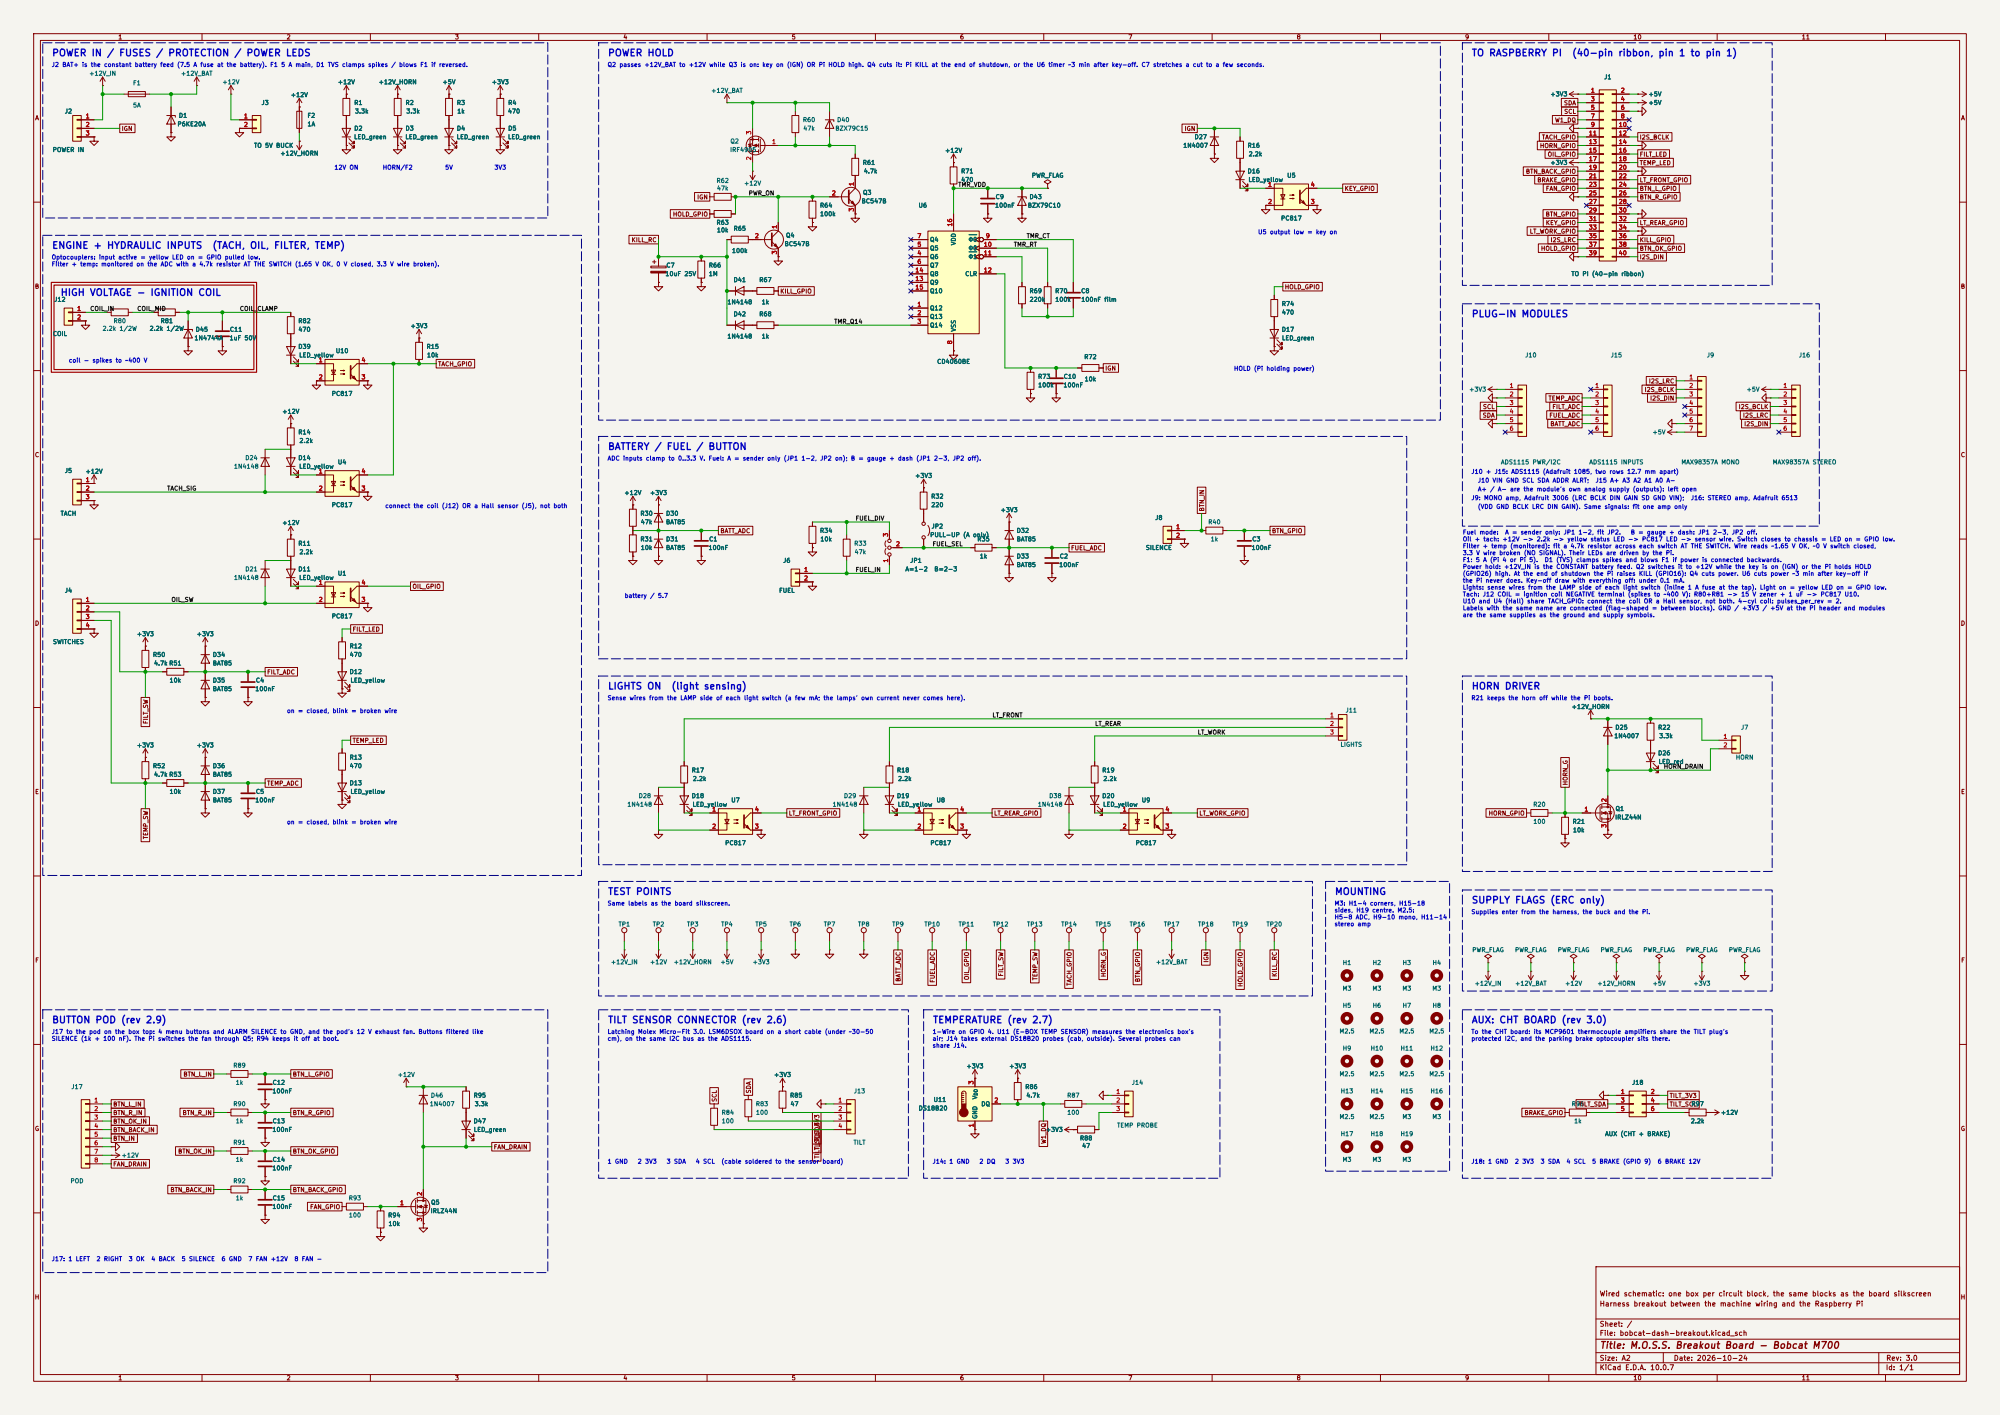
[picture p22: page 1]

POWER IN / FUSES / PROTECTION / POWER LEDS

TO RASPBERRY PI (40-pin ribbon, pin 1 to pin 1)
SDA
SCL

J2 BAT+ is the constant battery feed (7.5 A fuse at the battery). F1 5 A main, D1 TVS clamps spikes / blows F1 if reversed.

3V3 ENGINE + HYDRAULIC INPUTS (TACH, OIL, FILTER, TEMP)

Optocouplers: input active = yellow LED on = GPIO pulled low. Filter + temp: monitored on the ADC with a 4.7k resistor AT THE SWITCH (1.65 V OK, 0 V closed, 3.3 V wire broken).

ADC inputs clamp to 0..3.3 V. Fuel: A = sender only (JP1 1-2, JP2 on); B = gauge + dash (JP1 2-3, JP2 off).

J10 + J15: ADS1115 (Adafruit 1085, two rows 12.7 mm apart)
J10 VIN GND SCL SDA ADDR ALRT; J15 A+ A3 A2 A1 A0 A-
A+ / A- are the module's own analog supply (outputs): left open
J9: MONO amp, Adafruit 3006 (LRC BCLK DIN GAIN SD GND VIN); J16: STEREO amp, Adafruit 6513
(VDD GND BCLK LRC DIN GAIN). Same signals: fit one amp only

connect the coil (J12) OR a Hall sensor (J5), not both

(GPIO26) high. At the end of shutdown the Pi raises KILL (GPIO16): Q4 cuts power. U6 cuts power ~3 min after key-off if
the Pi never does. Key-off draw with everything off: under 0.1 mA. Lights: sense wires from the LAMP side of each light switch (inline 1 A fuse at the tap). Light on = yellow LED on = GPIO low. Tach: J12 COIL = ignition coil NEGATIVE terminal (spikes to ~400 V): R80+R81 -> 15 V zener + 1 uF -> PC817 U10. U10 and U4 (Hall) share TACH_GPIO: connect the coil OR a Hall sensor, not both. 4-cyl coil: pulses_per_rev = 2. Labels with the same name are connected (flag-shaped = between blocks). GND / +3V3 / +5V at the Pi header and modules are the same supplies as the ground and supply symbols.

battery / 5.7 LIGHTS ON (light sensing)

R21 keeps the horn off while the Pi boots. HORN DRIVER

Sense wires from the LAMP side of each light switch (a few mA; the lamps' own current never comes here). on = closed, blink = broken wire on = closed, blink = broken wire

M3: H1-4 corners, H15-18
sides, H19 centre. M2.5: H5-8 ADC, H9-10 mono, H11-14

TILT SENSOR CONNECTOR (rev 2.6)

Latching Molex Micro-Fit 3.0. LSM6DSOX board on a short cable (under ~30-50

protected I2C, and the parking brake optocoupler sits there. 1-Wire on GPIO 4. U11 (E-BOX TEMP SENSOR) measures the electronics box's air; J14 takes external DS18B20 probes (cab, outside). Several probes can

To the CHT board: its MCP9601 thermocouple amplifiers share the TILT plug's

J18: 1 GND 2 3V3 3 SDA 4 SCL 5 BRAKE (GPIO 9) 6 BRAKE 12V

J17: 1 LEFT 2 RIGHT 3 OK 4 BACK 5 SILENCE 6 GND 7 FAN +12V 8 FAN -

Wired schematic: one box per circuit block, the same blocks as the board silkscreen
Harness breakout between the machine wiring and the Raspberry Pi

Sheet: /
File: bobcat-dash-breakout.kicad_sch
Title: M.O.S.S. Breakout Board - Bobcat M700

Size: A2 | Rev: 3.0
KiCad E.D.A. 10.0.7 | Id: 1/1
