ricsne2010/bobcat-dash/breakout-board/cht-board/docs/schematic.pdf

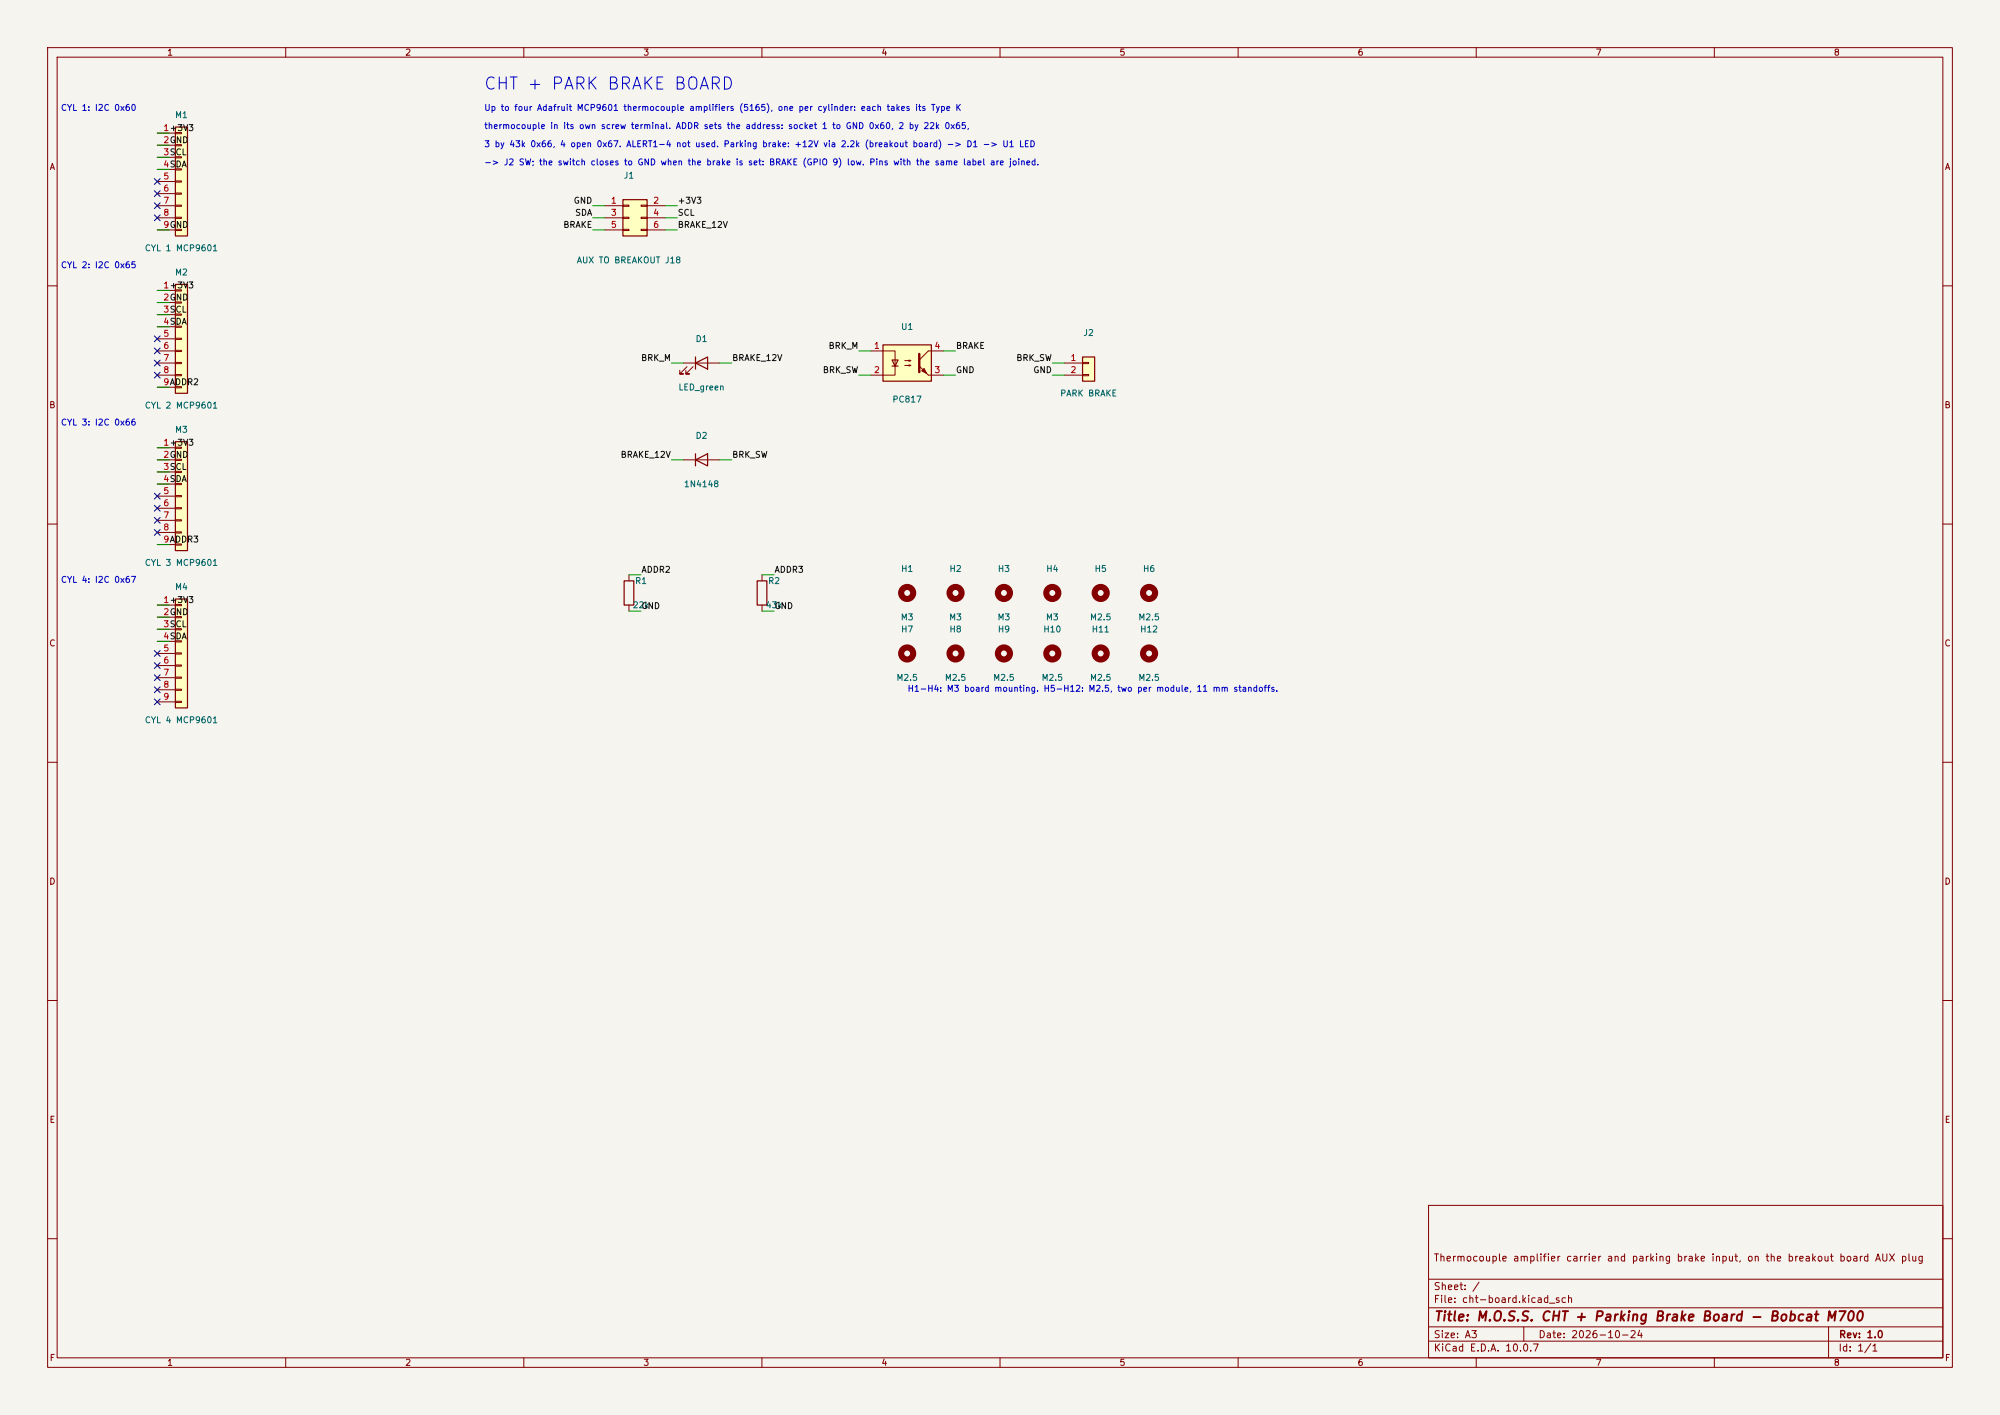
[picture p23: page 1]

thermocouple in its own screw terminal. ADDR sets the address: socket 1 to GND 0x60, 2 by 22k 0x65, 3 by 43k 0x66, 4 open 0x67. ALERT1-4 not used. Parking brake: +12V via 2.2k (breakout board) -> D1 -> U1 LED -> J2 SW; the switch closes to GND when the brake is set: BRAKE (GPIO 9) low. Pins with the same label are joined.

Thermocouple amplifier carrier and parking brake input, on the breakout board AUX plug

Sheet: /
File: cht-board.kicad_sch
Title: M.O.S.S. CHT + Parking Brake Board - Bobcat M700

Size: A3 | Rev: 1.0 | F Date: 2026-10-24
KiCad E.D.A. 10.0.7 | Id: 1/1
