ricsne2010/bobcat-dash/breakout-board/ads1115-adapter/docs/schematic.pdf

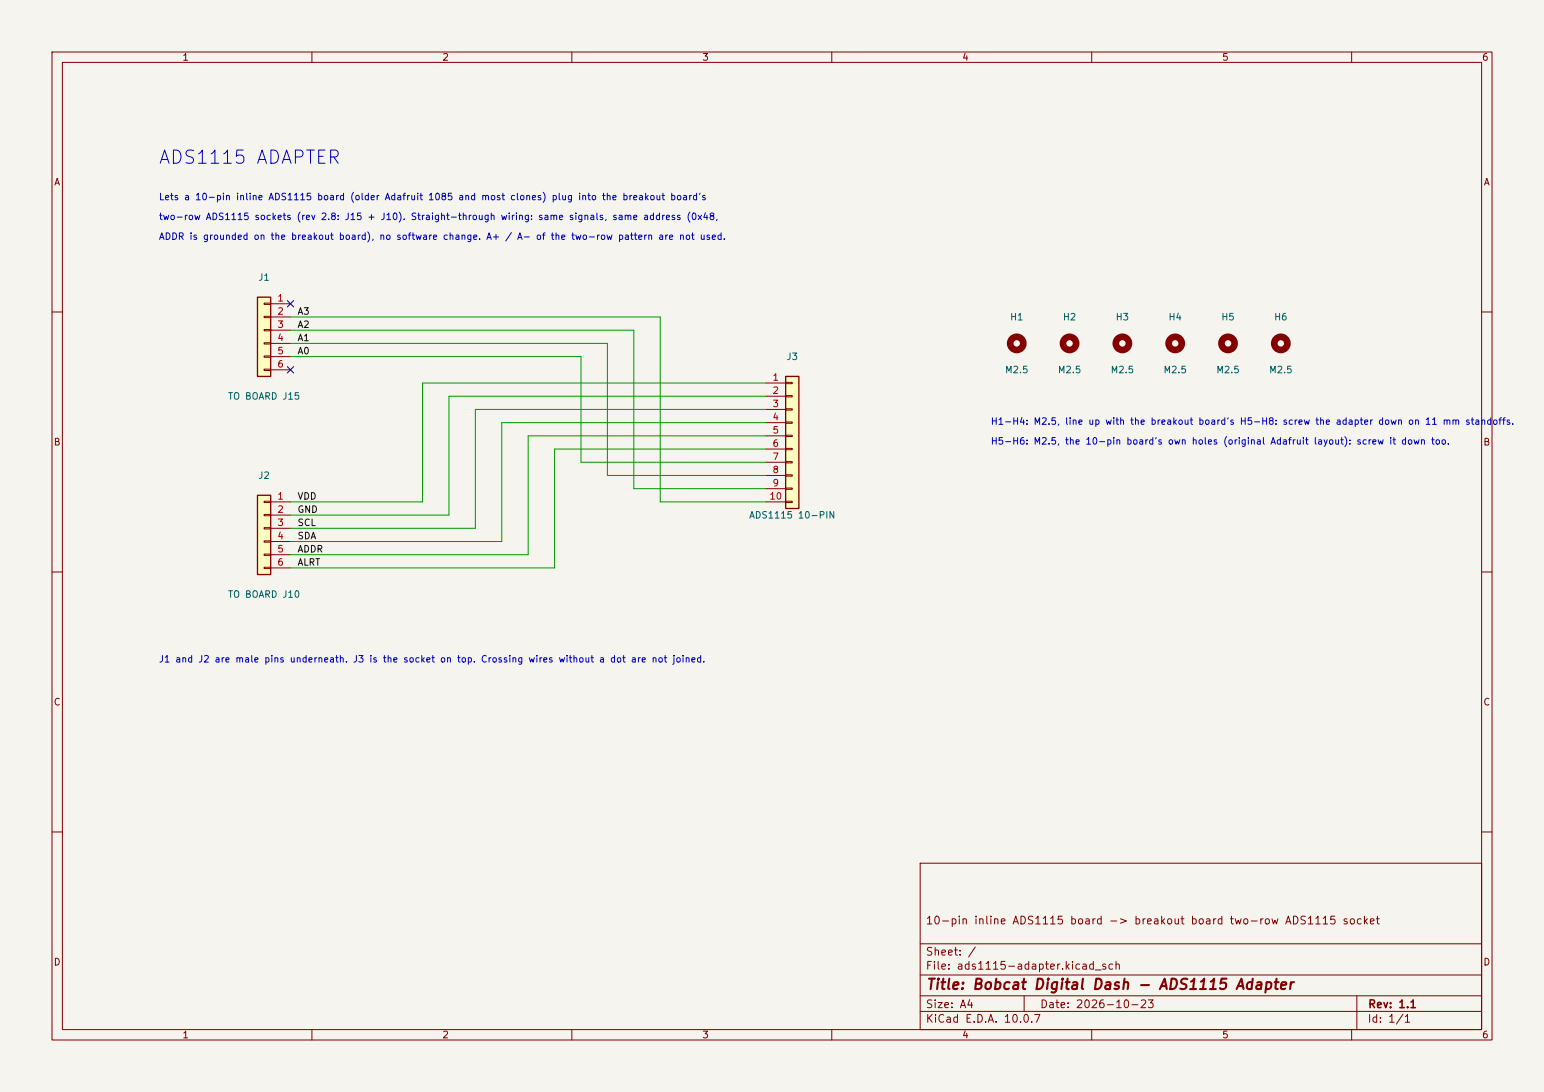
[picture p24: page 1]

ADDR is grounded on the breakout board), no software change. A+ / A- of the two-row pattern are not used.

J1 and J2 are male pins underneath. J3 is the socket on top. Crossing wires without a dot are not joined.

Sheet: /
File: ads1115-adapter.kicad_sch
Title: Bobcat Digital Dash - ADS1115 Adapter

Size: A4 | Rev: 1.1
KiCad E.D.A. 10.0.7 | Id: 1/1
