ricsne2010/bobcat-dash/(list of files, drawings)

Other design files:
breakout-board/ads1115-adapter/generator/sch_uuids.json
breakout-board/cht-board/generator/sch_uuids.json
breakout-board/generator/sch_uuids.json
