ricsne2010/bobcat-dash/breakout-board/kicad/bobcat-dash-breakout.kicad_pcb

## KiCad design breakout-board/kicad/bobcat-dash-breakout.kicad_pcb (2026-10-24)

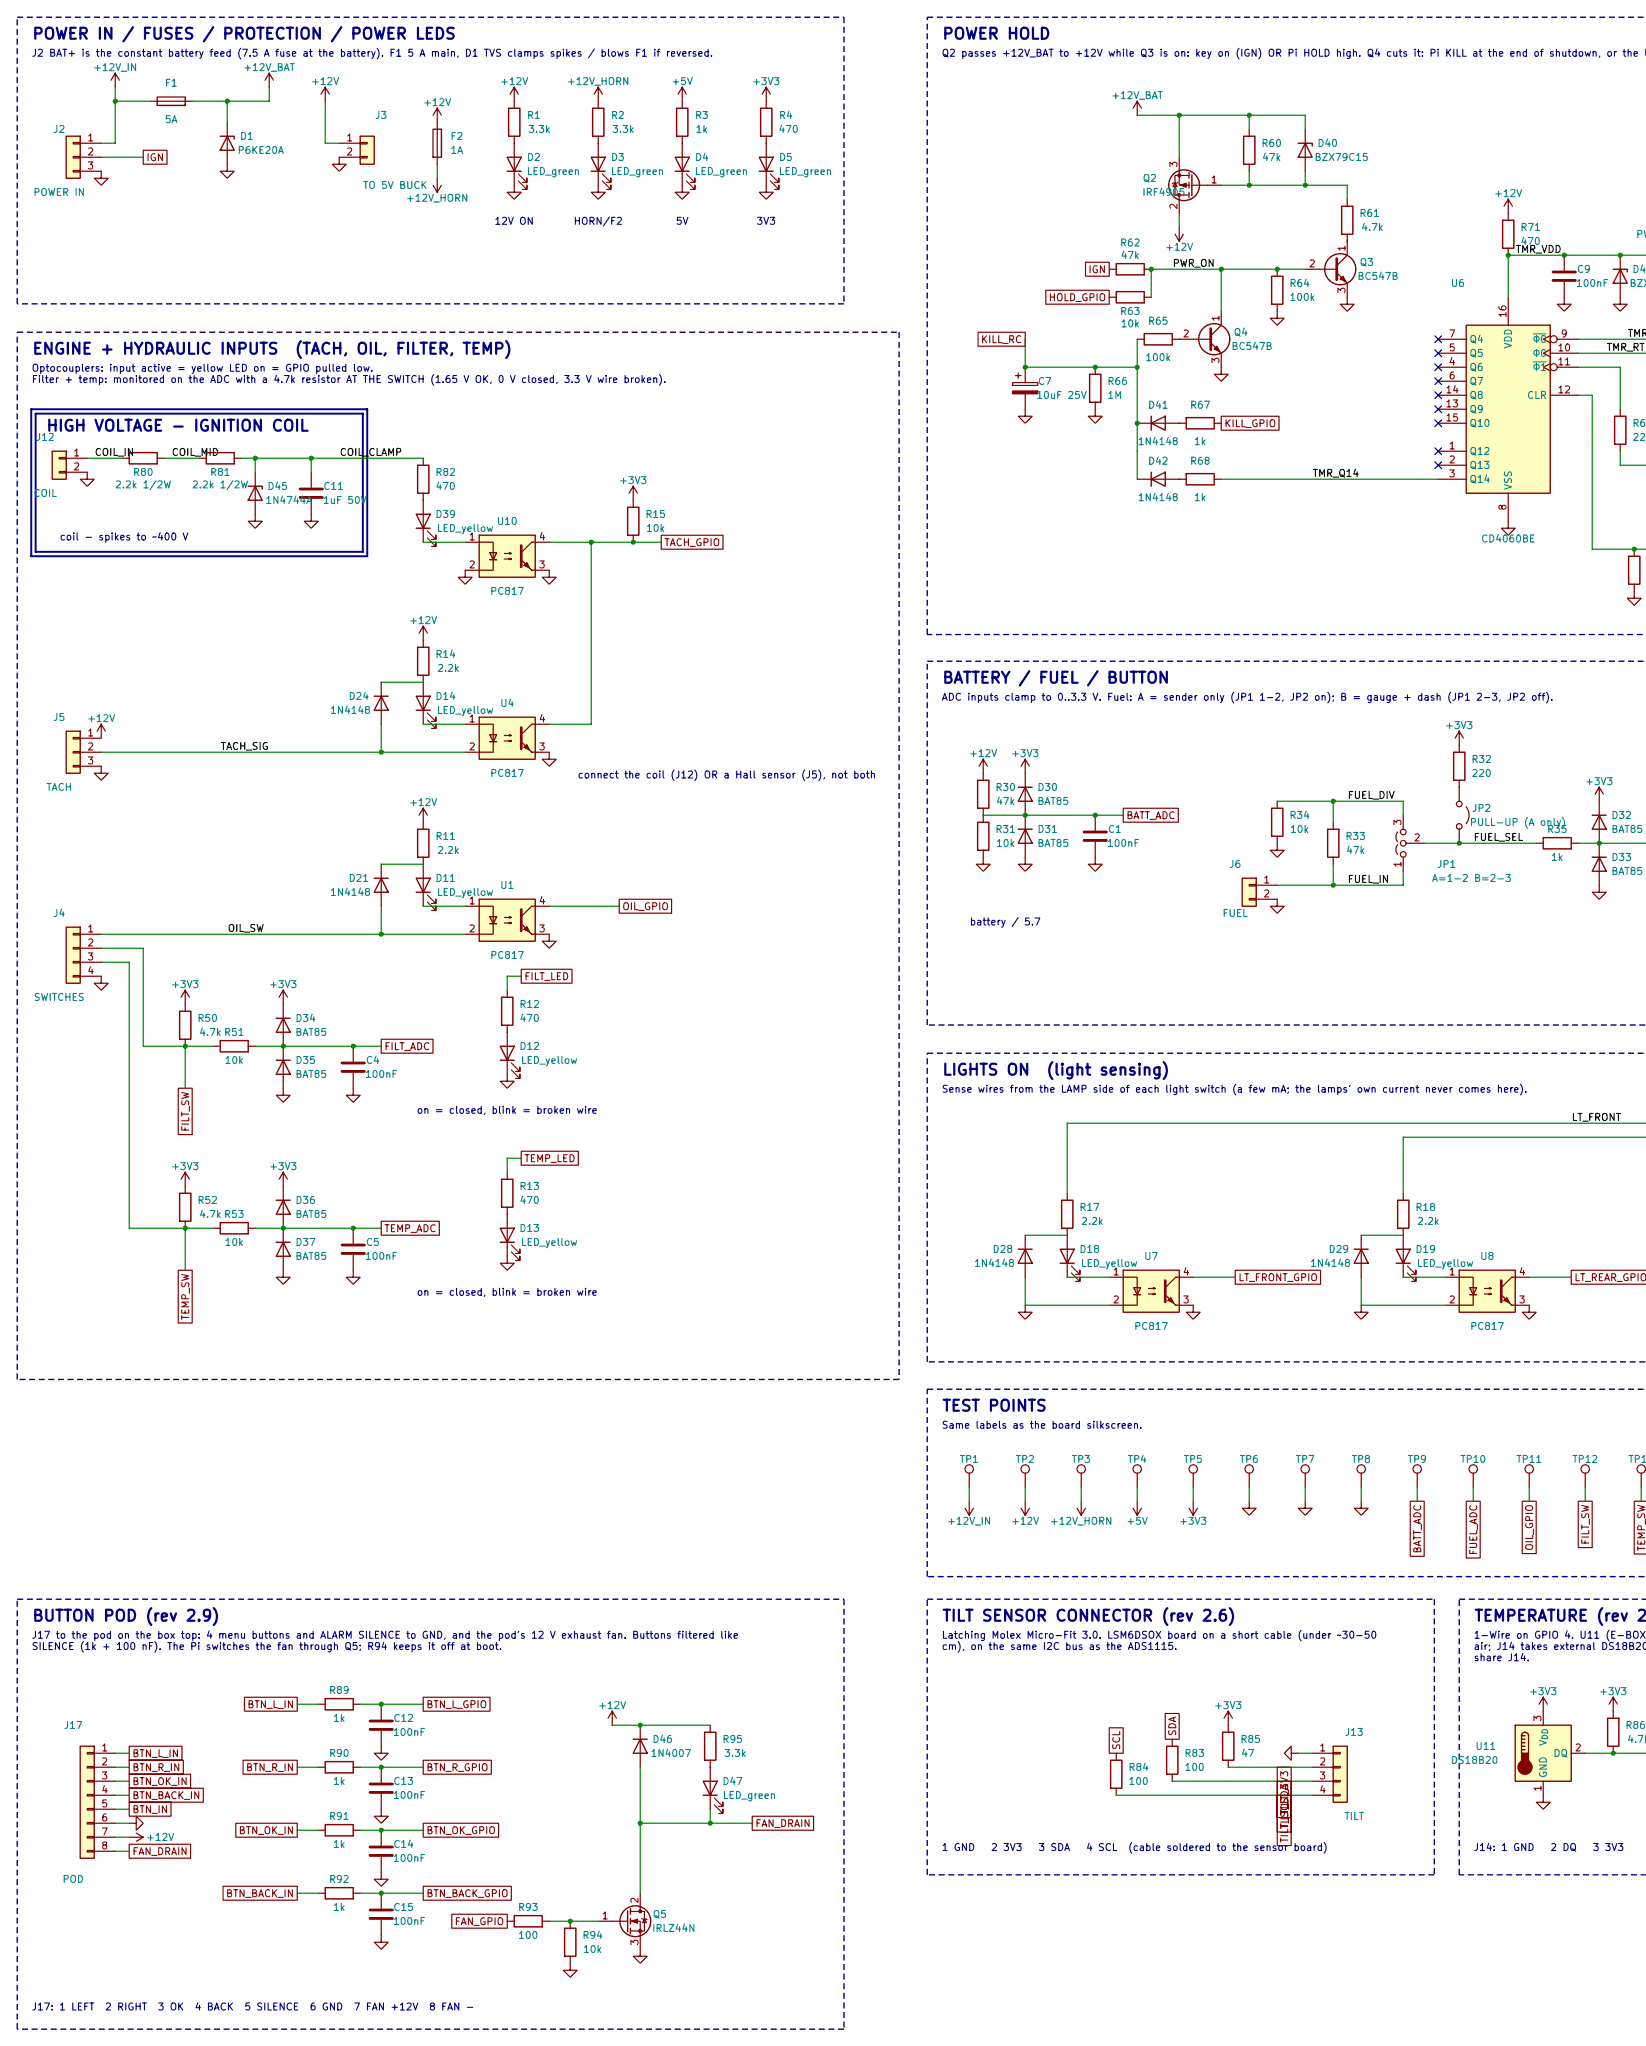
[picture p25: schematic bobcat-dash-breakout.kicad_sch, M.O.S.S. Breakout Board - Bobcat M700, part in row 1, column 1]

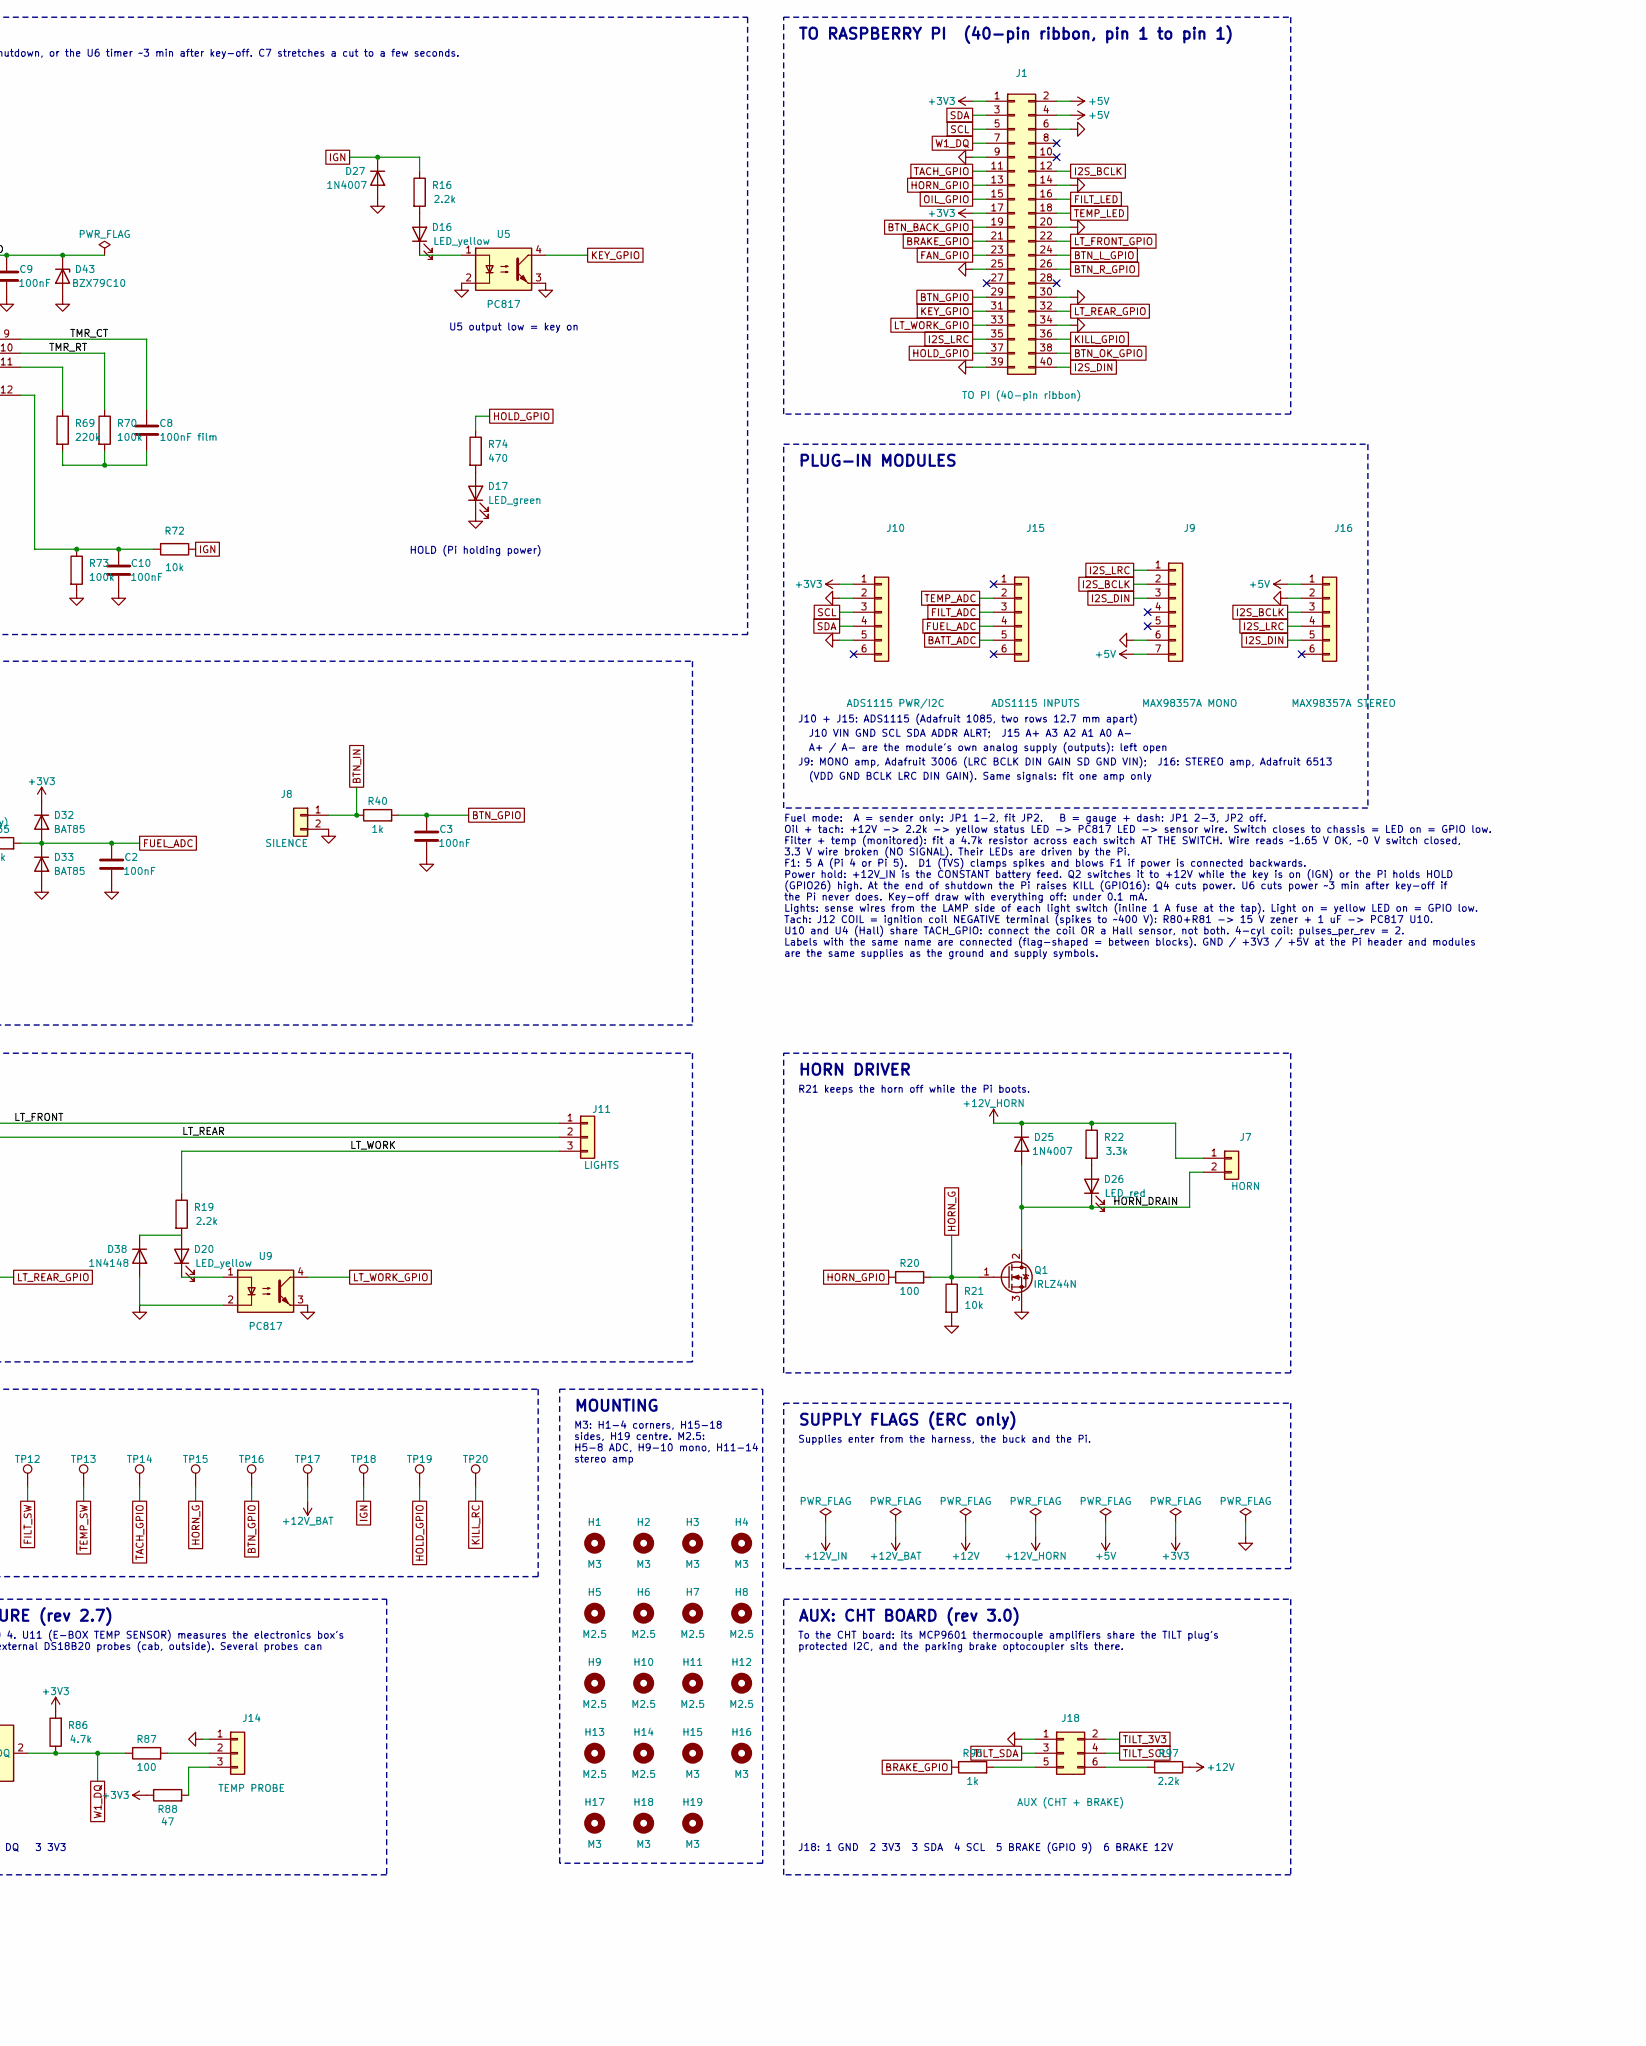
[picture p26: schematic bobcat-dash-breakout.kicad_sch, M.O.S.S. Breakout Board - Bobcat M700, part in row 1, column 2]

Parts:
C1, C2, C3, C4, C5, C9, C10, C12, C13, C14, C15: 100nF; C_Disc_D5.0mm_W2.5mm_P5.00mm
C7: 10uF 25V; CP_Radial_D5.0mm_P2.00mm
C8: 100nF film; C_Disc_D5.0mm_W2.5mm_P5.00mm
C11: 1uF 50V; C_Disc_D5.0mm_W2.5mm_P5.00mm
D1: P6KE20A; D_DO-15_P12.70mm_Horizontal
D2, D3, D4, D5, D17, D47: LED_green; LED_D3.0mm
D11, D12, D13, D14, D16, D18, D19, D20, D39: LED_yellow; LED_D3.0mm
D21, D24, D41, D42: 1N4148; D_DO-35_SOD27_P7.62mm_Horizontal
D25, D46: 1N4007; D_DO-41_SOD81_P10.16mm_Horizontal
D26: LED_red; LED_D3.0mm
D27: 1N4007; D_DO-41_SOD81_P7.62mm_Horizontal
D28, D29, D38: 1N4148; D_DO-35_SOD27_P2.54mm_Vertical_AnodeUp
D30, D31, D32, D33, D34, D35, D36, D37: BAT85; D_DO-35_SOD27_P7.62mm_Horizontal
D40: BZX79C15; D_DO-35_SOD27_P7.62mm_Horizontal
D43: BZX79C10; D_DO-35_SOD27_P7.62mm_Horizontal
D45: 1N4744A; D_DO-41_SOD81_P10.16mm_Horizontal
F1: 5A; Fuseholder_Blade_Mini_Keystone_3568
F2: 1A; Fuseholder_Blade_Mini_Keystone_3568
H1, H2, H3, H4, H15, H16, H17, H18, H19: M3; MountingHole_3.2mm_M3
H5, H6, H7, H8, H9, H10, H11, H12, H13, H14: M2.5; MountingHole_2.7mm_M2.5
J1: TO PI (40-pin ribbon); IDC-Header_2x20_P2.54mm_Vertical
J2: POWER IN; PhoenixContact_MSTBA_2,5_3-G-5,08_1x03_P5.08mm_Horizontal
J3: TO 5V BUCK; PhoenixContact_MSTBA_2,5_2-G-5,08_1x02_P5.08mm_Horizontal
J4: SWITCHES; PhoenixContact_MSTBA_2,5_4-G-5,08_1x04_P5.08mm_Horizontal
J5: TACH; PhoenixContact_MSTBA_2,5_3-G-5,08_1x03_P5.08mm_Horizontal
J6: FUEL; PhoenixContact_MSTBA_2,5_2-G-5,08_1x02_P5.08mm_Horizontal
J7: HORN; PhoenixContact_MSTBA_2,5_2-G-5,08_1x02_P5.08mm_Horizontal
J8: SILENCE; PhoenixContact_MSTBA_2,5_2-G-5,08_1x02_P5.08mm_Horizontal
J9: MAX98357A MONO; PinSocket_1x07_P2.54mm_Vertical
J10: ADS1115 PWR/I2C; PinSocket_1x06_P2.54mm_Vertical
J11: LIGHTS; PhoenixContact_MSTBA_2,5_3-G-5,08_1x03_P5.08mm_Horizontal
J12: COIL; PhoenixContact_MSTBA_2,5_2-G-5,08_1x02_P5.08mm_Horizontal
J13: TILT; Molex_Micro-Fit_3.0_43650-0415_1x04_P3.00mm_Vertical
J14: TEMP PROBE; Molex_Micro-Fit_3.0_43650-0315_1x03_P3.00mm_Vertical
J15: ADS1115 INPUTS; PinSocket_1x06_P2.54mm_Vertical
J16: MAX98357A STEREO; PinSocket_1x06_P2.54mm_Vertical
J17: POD; Molex_Micro-Fit_3.0_43650-0815_1x08_P3.00mm_Vertical
J18: AUX (CHT + BRAKE); Molex_Micro-Fit_3.0_43045-0612_2x03_P3.00mm_Vertical
JP1: A=1-2 B=2-3; PinHeader_1x03_P2.54mm_Vertical
JP2: PULL-UP (A only); PinHeader_1x02_P2.54mm_Vertical
Q1, Q5: IRLZ44N; TO-220-3_Vertical
Q2: IRF4905; TO-220-3_Vertical
Q3, Q4: BC547B; TO-92_Inline_Wide
R1, R2, R22, R95: 3.3k; R_Axial_DIN0207_L6.3mm_D2.5mm_P7.62mm_Horizontal
R3, R35, R40, R67, R68, R89, R90, R91, R92, R96: 1k; R_Axial_DIN0207_L6.3mm_D2.5mm_P7.62mm_Horizontal
R4, R12, R13, R71, R74, R82: 470; R_Axial_DIN0207_L6.3mm_D2.5mm_P7.62mm_Horizontal
R11, R14, R16, R17, R18, R19, R97: 2.2k; R_Axial_DIN0207_L6.3mm_D2.5mm_P7.62mm_Horizontal
R15, R21, R31, R34, R51, R53, R63, R72, R94: 10k; R_Axial_DIN0207_L6.3mm_D2.5mm_P7.62mm_Horizontal
R20, R83, R84, R87, R93: 100; R_Axial_DIN0207_L6.3mm_D2.5mm_P7.62mm_Horizontal
R30, R33, R60, R62: 47k; R_Axial_DIN0207_L6.3mm_D2.5mm_P7.62mm_Horizontal
R32: 220; R_Axial_DIN0207_L6.3mm_D2.5mm_P7.62mm_Horizontal
R50, R52, R61, R86: 4.7k; R_Axial_DIN0207_L6.3mm_D2.5mm_P7.62mm_Horizontal
R64, R65, R70, R73: 100k; R_Axial_DIN0207_L6.3mm_D2.5mm_P7.62mm_Horizontal
R66: 1M; R_Axial_DIN0207_L6.3mm_D2.5mm_P7.62mm_Horizontal
R69: 220k; R_Axial_DIN0207_L6.3mm_D2.5mm_P7.62mm_Horizontal
R80, R81: 2.2k 1/2W; R_Axial_DIN0309_L9.0mm_D3.2mm_P12.70mm_Horizontal
R85, R88: 47; R_Axial_DIN0207_L6.3mm_D2.5mm_P7.62mm_Horizontal
TP1: +12V_IN; TestPoint_THTPad_D2.0mm_Drill1.0mm
TP2: +12V; TestPoint_THTPad_D2.0mm_Drill1.0mm
TP3: +12V_HORN; TestPoint_THTPad_D2.0mm_Drill1.0mm
TP4: +5V; TestPoint_THTPad_D2.0mm_Drill1.0mm
TP5: +3V3; TestPoint_THTPad_D2.0mm_Drill1.0mm
TP6, TP7, TP8: GND; TestPoint_Keystone_5005-5009_Compact
TP9: BATT_ADC; TestPoint_THTPad_D2.0mm_Drill1.0mm
TP10: FUEL_ADC; TestPoint_THTPad_D2.0mm_Drill1.0mm
TP11: OIL_GPIO; TestPoint_THTPad_D2.0mm_Drill1.0mm
TP12: FILT_SW; TestPoint_THTPad_D2.0mm_Drill1.0mm
TP13: TEMP_SW; TestPoint_THTPad_D2.0mm_Drill1.0mm
TP14: TACH_GPIO; TestPoint_THTPad_D2.0mm_Drill1.0mm
TP15: HORN_G; TestPoint_THTPad_D2.0mm_Drill1.0mm
TP16: BTN_GPIO; TestPoint_THTPad_D2.0mm_Drill1.0mm
TP17: +12V_BAT; TestPoint_THTPad_D2.0mm_Drill1.0mm
TP18: IGN; TestPoint_THTPad_D2.0mm_Drill1.0mm
TP19: HOLD_GPIO; TestPoint_THTPad_D2.0mm_Drill1.0mm
TP20: KILL_RC; TestPoint_THTPad_D2.0mm_Drill1.0mm
U1, U4, U5, U7, U8, U9, U10: PC817; DIP-4_W7.62mm
U6: CD4060BE; DIP-16_W7.62mm
U11: DS18B20; TO-92_Inline_Wide

Connections:
+3V3: D30.1 (K), D32.1 (K), D34.1 (K), D36.1 (K), J1.1, J1.17, J10.1, R4.1, R15.1, R32.1, R50.1, R52.1, R85.1, R86.2, R88.1, TP5.1, U11.3 (V_{DD})
+5V: J1.2, J1.4, J9.7, J16.1, R3.1, TP4.1
+12V: D46.1 (K), F2.1, J3.1, J5.1, J17.7, Q2.2 (D), R1.1, R11.1, R14.1, R30.1, R71.1, R95.1, R97.1, TP2.1
+12V_BAT: D1.1 (K), D40.1 (K), F1.2, Q2.3 (S), R60.1, TP17.1
+12V_HORN: D25.1 (K), F2.2, J7.1, R2.1, R22.1, TP3.1
+12V_IN: F1.1, J2.1, TP1.1
/COIL_CLAMP: C11.1, D45.1 (K), R81.2, R82.1
/COIL_IN: J12.1, R80.1
/COIL_MID: R80.2, R81.1
/FUEL_DIV: JP1.3 (B), R33.2, R34.1
/FUEL_IN: J6.1, JP1.1 (A), R33.1
/FUEL_SEL: JP1.2 (C), JP2.2 (B), R35.1
/HORN_DRAIN: D25.2 (A), D26.1 (K), J7.2, Q1.2 (D)
/LT_FRONT: J11.1, R17.1
/LT_REAR: J11.2, R18.1
/LT_WORK: J11.3, R19.1
/OIL_SW: D21.2 (A), J4.1, U1.2
/PWR_ON: Q3.2 (B), Q4.1 (C), R62.2, R63.2, R64.1
/TACH_SIG: D24.2 (A), J5.2, U4.2
/TMR_CT: C8.1, U6.9 (~Φ0)
/TMR_Q14: R68.1, U6.3 (Q14)
/TMR_RT: R70.1, U6.10 (Φ0)
/TMR_VDD: C9.1, D43.1 (K), R71.2, U6.16 (VDD)
BATT_ADC: C1.1, D30.2 (A), D31.1 (K), J15.5, R30.2, R31.1, TP9.1
BRAKE_GPIO: J1.21, R96.1
BTN_BACK_GPIO: C15.1, J1.19, R92.2
BTN_BACK_IN: J17.4, R92.1
BTN_GPIO: C3.1, J1.29, R40.2, TP16.1
BTN_IN: J8.1, J17.5, R40.1
BTN_L_GPIO: C12.1, J1.24, R89.2
BTN_L_IN: J17.1, R89.1
BTN_OK_GPIO: C14.1, J1.38, R91.2
BTN_OK_IN: J17.3, R91.1
BTN_R_GPIO: C13.1, J1.26, R90.2
BTN_R_IN: J17.2, R90.1
FAN_DRAIN: D46.2 (A), D47.1 (K), J17.8, Q5.2 (D)
FAN_GPIO: J1.23, R93.1
FILT_ADC: C4.1, D34.2 (A), D35.1 (K), J15.3, R51.2
FILT_LED: J1.16, R12.1
FILT_SW: J4.2, R50.2, R51.1, TP12.1
FUEL_ADC: C2.1, D32.2 (A), D33.1 (K), J15.4, R35.2, TP10.1
GND: C1.2, C2.2, C3.2, C4.2, C5.2, C7.2, C9.2, C10.2, C11.2, C12.2, C13.2, C14.2, C15.2, D1.2 (A), D2.1 (K), D3.1 (K), D4.1 (K), D5.1 (K), D12.1 (K), D13.1 (K), D17.1 (K), D27.2 (A), D28.2 (A), D29.2 (A), D31.2 (A), D33.2 (A), D35.2 (A), D37.2 (A), D38.2 (A), D43.2 (A), D45.2 (A), J1.6, J1.9, J1.14, J1.20, J1.25, J1.30, J1.34, J1.39, J2.3, J3.2, J4.4, J5.3, J6.2, J8.2, J9.6, J10.2, J10.5, J12.2, J13.1, J14.1, J16.2, J17.6, J18.1, Q1.3 (S), Q3.3 (E), Q4.3 (E), Q5.3 (S), R21.2, R31.2, R34.2, R64.2, R66.2, R73.2, R94.2, TP6.1, TP7.1, TP8.1, U1.3, U4.3, U5.2, U5.3, U6.8 (VSS), U7.2, U7.3, U8.2, U8.3, U9.2, U9.3, U10.2, U10.3, U11.1 (GND)
HOLD_GPIO: J1.37, R63.1, R74.1, TP19.1
HORN_G: Q1.1 (G), R20.2, R21.1, TP15.1
HORN_GPIO: J1.13, R20.1
I2S_BCLK: J1.12, J9.2, J16.3
I2S_DIN: J1.40, J9.3, J16.5
I2S_LRC: J1.35, J9.1, J16.4
IGN: D27.1 (K), J2.2, R16.1, R62.1, R72.1, TP18.1
KEY_GPIO: J1.31, U5.4
KILL_GPIO: J1.36, R67.1
KILL_RC: C7.1, D41.1 (K), D42.1 (K), R65.1, R66.1, TP20.1
LT_FRONT_GPIO: J1.22, U7.4
LT_REAR_GPIO: J1.32, U8.4
LT_WORK_GPIO: J1.33, U9.4
unnamed: C8.2, R69.2, R70.2
unnamed: D2.2 (A), R1.2
unnamed: D3.2 (A), R2.2
unnamed: D4.2 (A), R3.2
unnamed: D5.2 (A), R4.2
unnamed: D11.2 (A), D21.1 (K), R11.2
unnamed: D11.1 (K), U1.1
unnamed: D12.2 (A), R12.2
unnamed: D13.2 (A), R13.2
unnamed: D14.2 (A), D24.1 (K), R14.2
unnamed: D14.1 (K), U4.1
unnamed: D16.2 (A), R16.2
unnamed: D16.1 (K), U5.1
unnamed: D17.2 (A), R74.2
unnamed: D18.2 (A), D28.1 (K), R17.2
unnamed: D18.1 (K), U7.1
unnamed: D19.2 (A), D29.1 (K), R18.2
unnamed: D19.1 (K), U8.1
unnamed: D20.2 (A), D38.1 (K), R19.2
unnamed: D20.1 (K), U9.1
unnamed: D26.2 (A), R22.2
unnamed: D39.2 (A), R82.2
unnamed: D39.1 (K), U10.1
unnamed: D40.2 (A), Q2.1 (G), R60.2, R61.1
unnamed: D41.2 (A), R67.2
unnamed: D42.2 (A), R68.2
unnamed: D47.2 (A), R95.2
unnamed: J14.2, R87.2
unnamed: J14.3, R88.2
unnamed: J18.5, R96.2
unnamed: J18.6, R97.2
unnamed: JP2.1 (A), R32.2
unnamed: Q3.1 (C), R61.2
unnamed: Q4.2 (B), R65.2
unnamed: Q5.1 (G), R93.2, R94.1
unnamed: C10.1, R72.2, R73.1, U6.12 (CLR)
unnamed: R69.1, U6.11 (~Φ1)
OIL_GPIO: J1.15, TP11.1, U1.4
SCL: J1.5, J10.3, R84.1
SDA: J1.3, J10.4, R83.1
TACH_GPIO: J1.11, R15.2, TP14.1, U4.4, U10.4
TEMP_ADC: C5.1, D36.2 (A), D37.1 (K), J15.2, R53.2
TEMP_LED: J1.18, R13.1
TEMP_SW: J4.3, R52.2, R53.1, TP13.1
TILT_3V3: J13.2, J18.2, R85.2
TILT_SCL: J13.4, J18.4, R84.2
TILT_SDA: J13.3, J18.3, R83.2
W1_DQ: J1.7, R86.1, R87.1, U11.2 (DQ)

Notes on the sheet:
POWER IN / FUSES / PROTECTION / POWER LEDS
J2 BAT+ is the constant battery feed (7.5 A fuse at the battery). F1 5 A main, D1 TVS clamps spikes / blows F1 if reversed.
12V ON
HORN/F2
3V3
ENGINE + HYDRAULIC INPUTS (TACH, OIL, FILTER, TEMP)
Optocouplers: input active = yellow LED on = GPIO pulled low. Filter + temp: monitored on the ADC with a 4.7k resistor AT THE SWITCH (1.65 V OK, 0 V closed, 3.3 V wire broken).
HIGH VOLTAGE - IGNITION COIL
coil - spikes to ~400 V
connect the coil (J12) OR a Hall sensor (J5), not both
on = closed, blink = broken wire
POWER HOLD
Q2 passes +12V_BAT to +12V while Q3 is on: key on (IGN) OR Pi HOLD high. Q4 cuts it: Pi KILL at the end of shutdown, or the U6 timer ~3 min after key-off. C7 stretches a cut to a few seconds.
HOLD (Pi holding power)
U5 output low = key on
BATTERY / FUEL / BUTTON
ADC inputs clamp to 0..3.3 V. Fuel: A = sender only (JP1 1-2, JP2 on); B = gauge + dash (JP1 2-3, JP2 off).
battery / 5.7
LIGHTS ON (light sensing)
Sense wires from the LAMP side of each light switch (a few mA; the lamps' own current never comes here).
TEST POINTS
Same labels as the board silkscreen.
MOUNTING
M3: H1-4 corners, H15-18 sides, H19 centre. M2.5: H5-8 ADC, H9-10 mono, H11-14 stereo amp
BUTTON POD (rev 2.9)
J17 to the pod on the box top: 4 menu buttons and ALARM SILENCE to GND, and the pod's 12 V exhaust fan. Buttons filtered like SILENCE (1k + 100 nF). The Pi switches the fan through Q5; R94 keeps it off at boot.
J17: 1 LEFT 2 RIGHT 3 OK 4 BACK 5 SILENCE 6 GND 7 FAN +12V 8 FAN -
TILT SENSOR CONNECTOR (rev 2.6)
Latching Molex Micro-Fit 3.0. LSM6DSOX board on a short cable (under ~30-50 cm), on the same I2C bus as the ADS1115.
1 GND 2 3V3 3 SDA 4 SCL (cable soldered to the sensor board)
TEMPERATURE (rev 2.7)
1-Wire on GPIO 4. U11 (E-BOX TEMP SENSOR) measures the electronics box's air; J14 takes external DS18B20 probes (cab, outside). Several probes can share J14.
J14: 1 GND 2 DQ 3 3V3
TO RASPBERRY PI (40-pin ribbon, pin 1 to pin 1)
PLUG-IN MODULES
J10 + J15: ADS1115 (Adafruit 1085, two rows 12.7 mm apart)
J10 VIN GND SCL SDA ADDR ALRT; J15 A+ A3 A2 A1 A0 A-
A+ / A- are the module's own analog supply (outputs): left open
J9: MONO amp, Adafruit 3006 (LRC BCLK DIN GAIN SD GND VIN); J16: STEREO amp, Adafruit 6513
(VDD GND BCLK LRC DIN GAIN). Same signals: fit one amp only
HORN DRIVER
R21 keeps the horn off while the Pi boots.
SUPPLY FLAGS (ERC only)
Supplies enter from the harness, the buck and the Pi.
AUX: CHT BOARD (rev 3.0)
To the CHT board: its MCP9601 thermocouple amplifiers share the TILT plug's protected I2C, and the parking brake optocoupler sits there.
J18: 1 GND 2 3V3 3 SDA 4 SCL 5 BRAKE (GPIO 9) 6 BRAKE 12V
Fuel mode: A = sender only: JP1 1-2, fit JP2. B = gauge + dash: JP1 2-3, JP2 off. Oil + tach: +12V -> 2.2k -> yellow status LED -> PC817 LED -> sensor wire. Switch closes to chassis = LED on = GPIO low. Filter + temp (monitored): fit a 4.7k resistor across each switch AT THE SWITCH. Wire reads ~1.6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

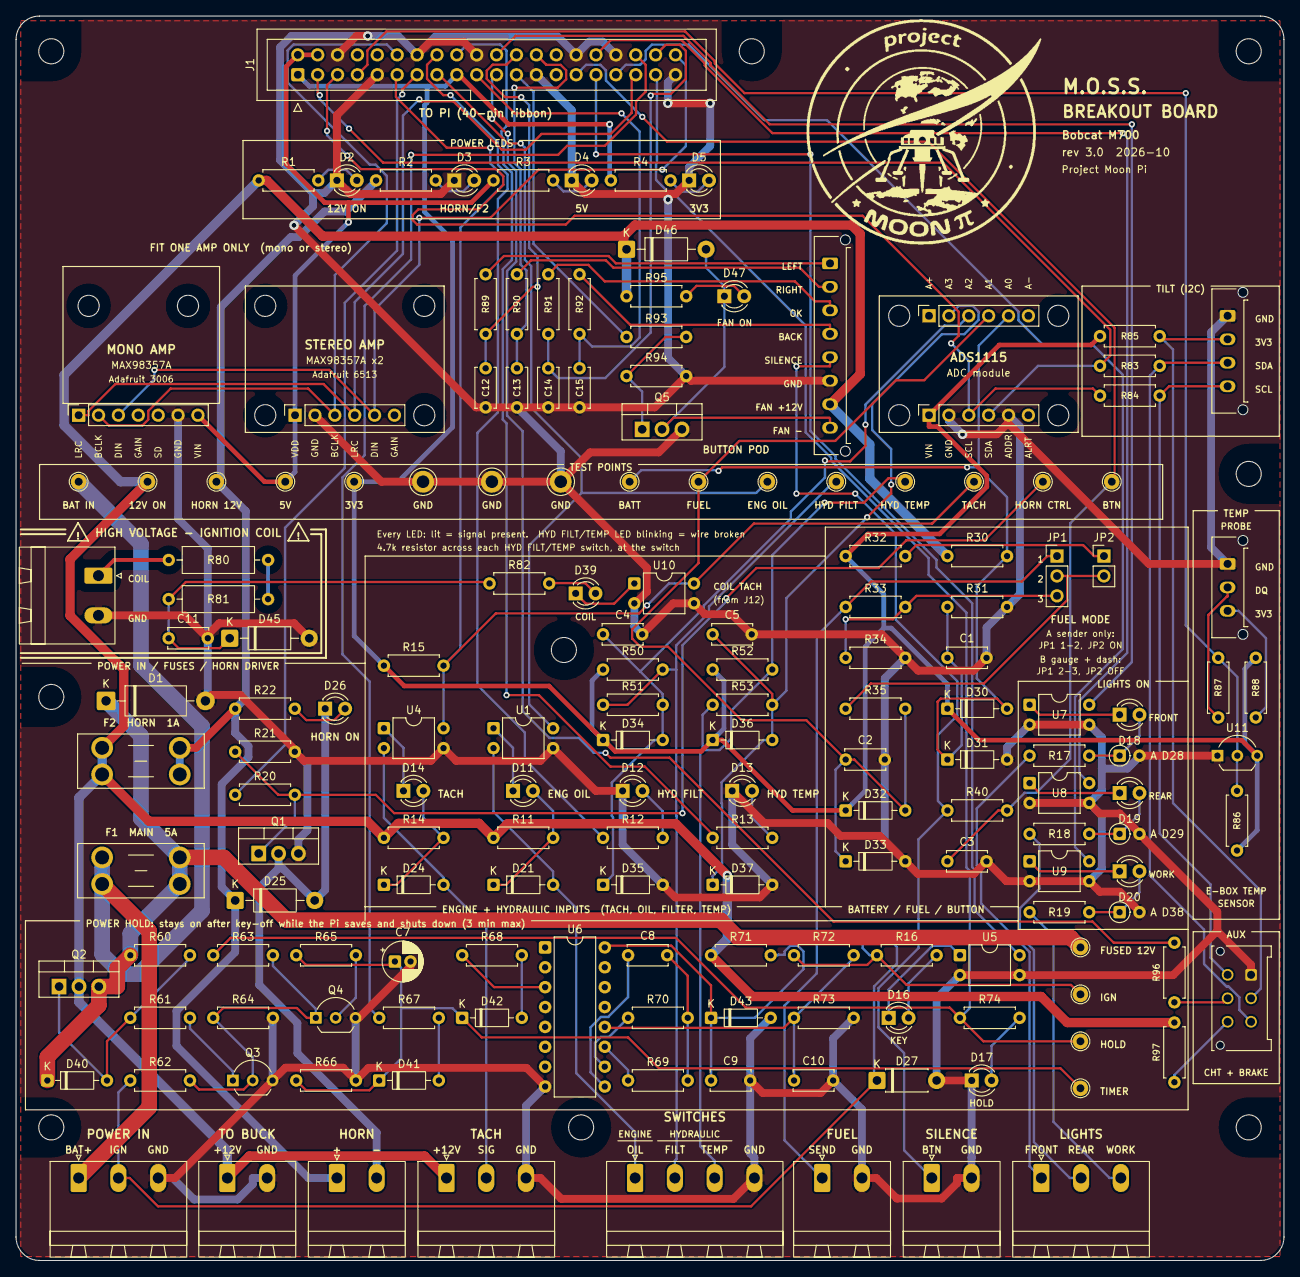
[picture p27: board bobcat-dash-breakout.kicad_pcb from above]

Board: 2 copper layers, 162.0 x 159.0 mm, 187 parts (0 on the bottom side), 103 nets.
