ricsne2010/bobcat-dash/breakout-board/cht-board/kicad/cht-board.kicad_pcb

## KiCad design breakout-board/cht-board/kicad/cht-board.kicad_pcb (2026-10-24)

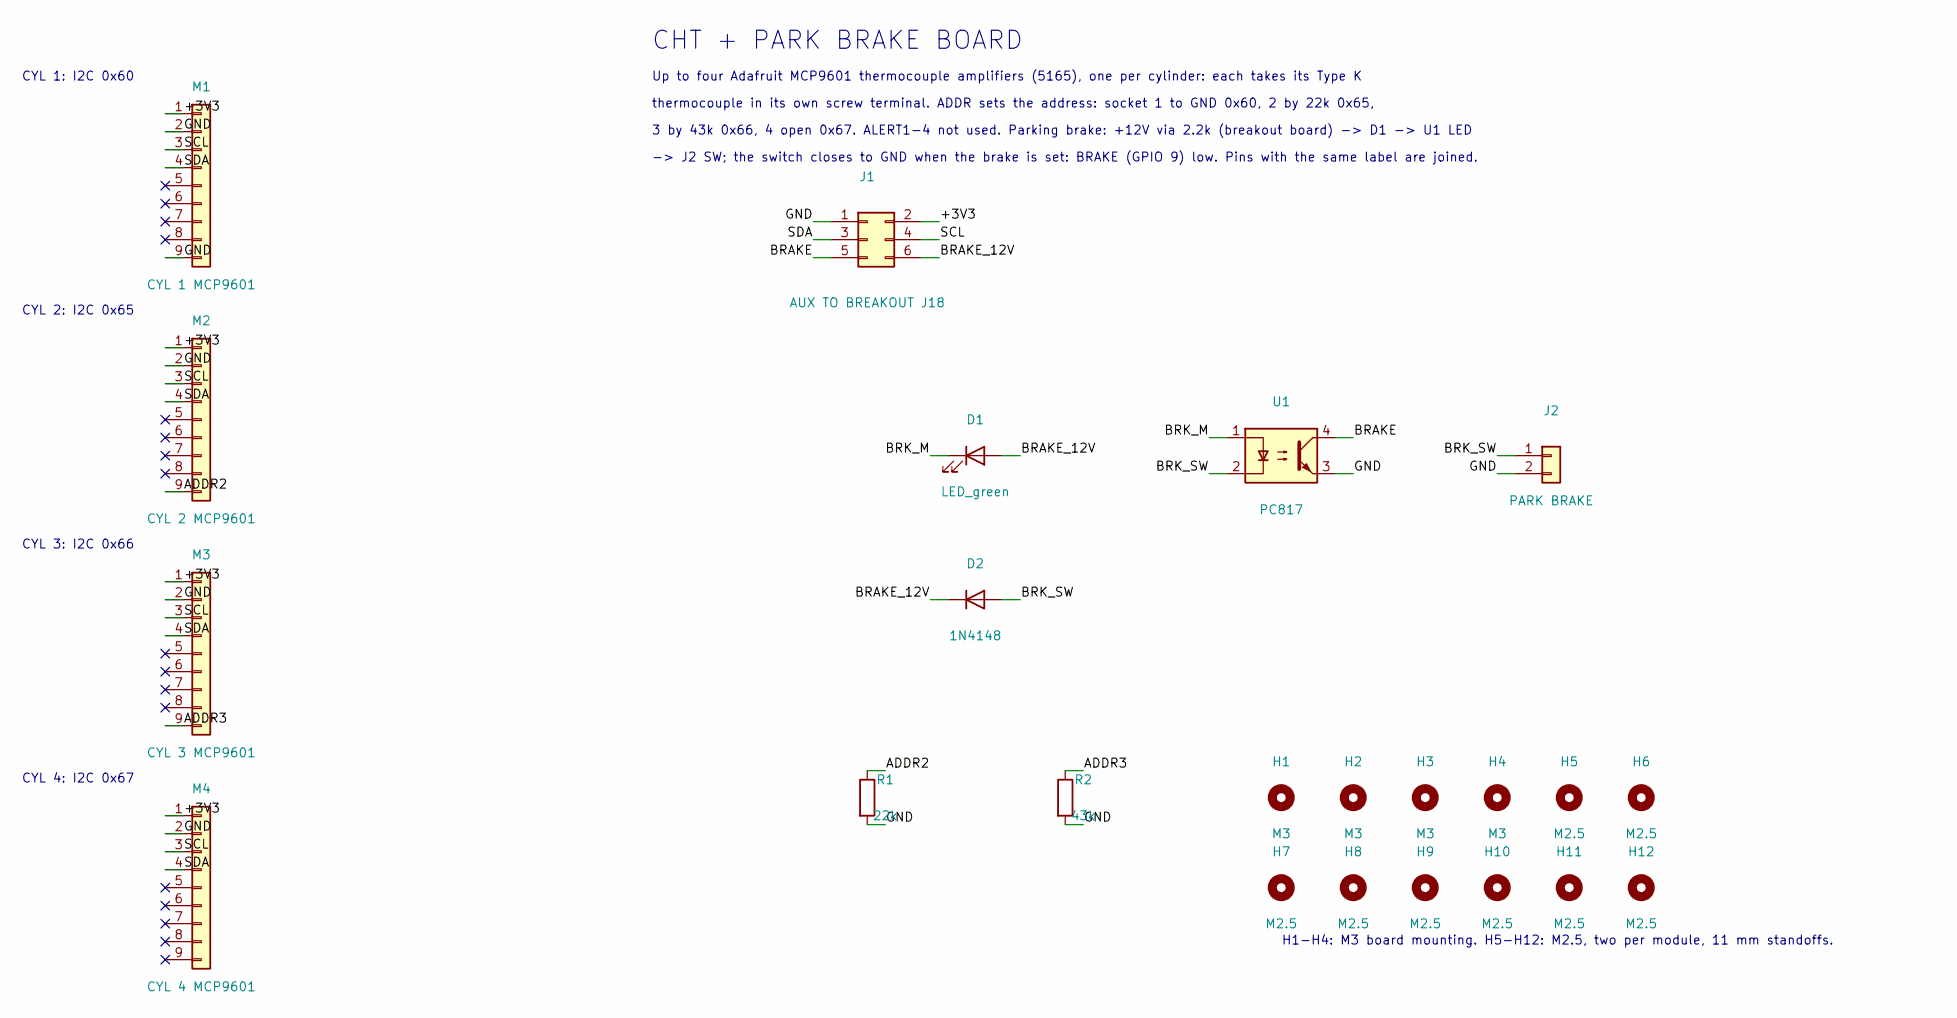
[picture p28: schematic cht-board.kicad_sch, M.O.S.S. CHT + Parking Brake Board - Bobcat M700]

Parts:
D1: LED_green; LED_D3.0mm
D2: 1N4148; D_DO-35_SOD27_P7.62mm_Horizontal
H1, H2, H3, H4: M3; MountingHole_3.2mm_M3
H5, H6, H7, H8, H9, H10, H11, H12: M2.5; MountingHole_2.7mm_M2.5
J1: AUX TO BREAKOUT J18; Molex_Micro-Fit_3.0_43045-0612_2x03_P3.00mm_Vertical
J2: PARK BRAKE; PhoenixContact_MSTBA_2,5_2-G-5,08_1x02_P5.08mm_Horizontal
M1: CYL 1 MCP9601; PinSocket_1x09_P2.54mm_Vertical
M2: CYL 2 MCP9601; PinSocket_1x09_P2.54mm_Vertical
M3: CYL 3 MCP9601; PinSocket_1x09_P2.54mm_Vertical
M4: CYL 4 MCP9601; PinSocket_1x09_P2.54mm_Vertical
R1: 22k; R_Axial_DIN0207_L6.3mm_D2.5mm_P7.62mm_Horizontal
R2: 43k; R_Axial_DIN0207_L6.3mm_D2.5mm_P7.62mm_Horizontal
U1: PC817; DIP-4_W7.62mm

Connections:
/+3V3: J1.2, M1.1, M2.1, M3.1, M4.1
/ADDR2: M2.9, R1.1
/ADDR3: M3.9, R2.1
/BRAKE: J1.5, U1.4
/BRAKE_12V: D1.2 (A), D2.1 (K), J1.6
/BRK_M: D1.1 (K), U1.1
/BRK_SW: D2.2 (A), J2.1, U1.2
/GND: J1.1, J2.2, M1.2, M1.9, M2.2, M3.2, M4.2, R1.2, R2.2, U1.3
/SCL: J1.4, M1.3, M2.3, M3.3, M4.3
/SDA: J1.3, M1.4, M2.4, M3.4, M4.4

Notes on the sheet:
CYL 1: I2C 0x60
CYL 2: I2C 0x65
CYL 3: I2C 0x66
CYL 4: I2C 0x67
CHT + PARK BRAKE BOARD
Up to four Adafruit MCP9601 thermocouple amplifiers (5165), one per cylinder: each takes its Type K
thermocouple in its own screw terminal. ADDR sets the address: socket 1 to GND 0x60, 2 by 22k 0x65,
3 by 43k 0x66, 4 open 0x67. ALERT1-4 not used. Parking brake: +12V via 2.2k (breakout board) -> D1 -> U1 LED
-> J2 SW; the switch closes to GND when the brake is set: BRAKE (GPIO 9) low. Pins with the same label are joined.
H1-H4: M3 board mounting. H5-H12: M2.5, two per module, 11 mm standoffs.

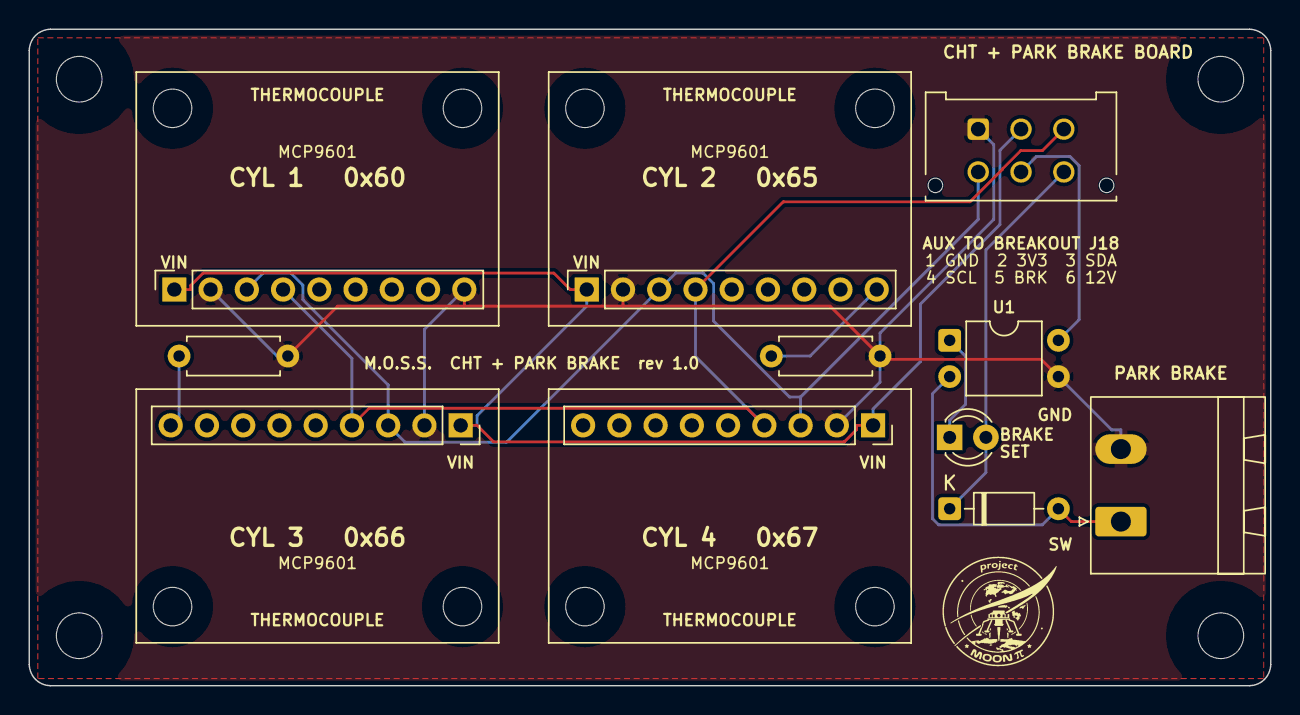
[picture p29: board cht-board.kicad_pcb from above]

Board: 2 copper layers, 87.0 x 46.0 mm, 23 parts (0 on the bottom side), 10 nets.
