ricsne2010/bobcat-dash/breakout-board/ads1115-adapter/kicad/ads1115-adapter.kicad_pcb

## KiCad design breakout-board/ads1115-adapter/kicad/ads1115-adapter.kicad_pcb (2026-10-24)

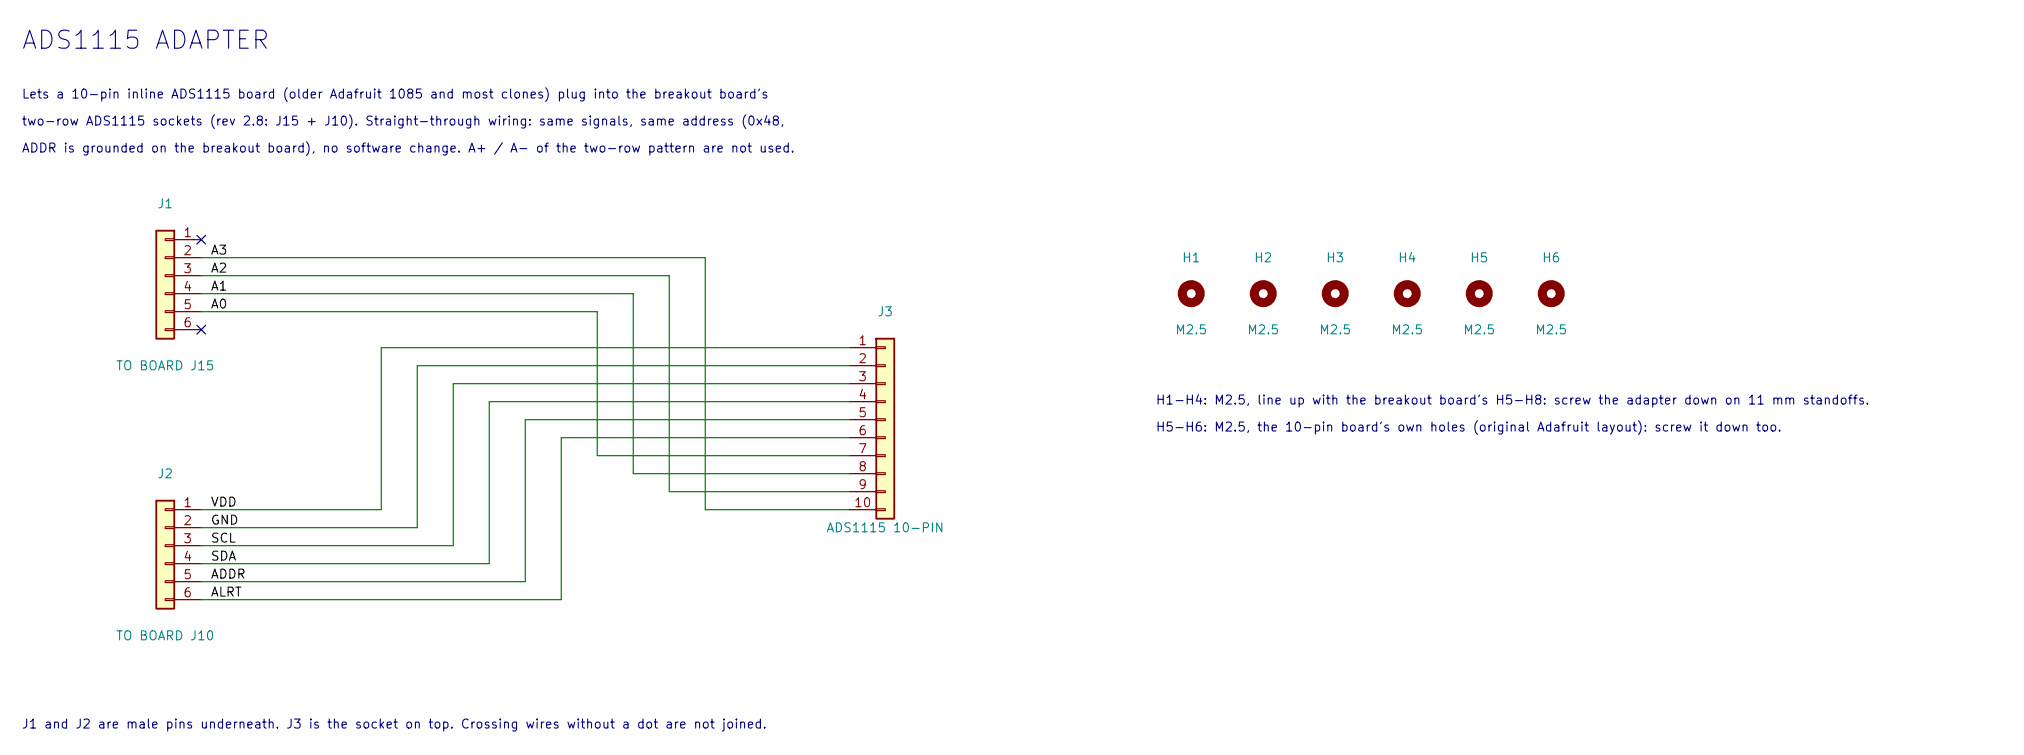
[picture p30: schematic ads1115-adapter.kicad_sch, Bobcat Digital Dash - ADS1115 Adapter]

Parts:
H1, H2, H3, H4, H5, H6: M2.5; MountingHole_2.7mm_M2.5
J1: TO BOARD J15; PinHeader_1x06_P2.54mm_Vertical
J2: TO BOARD J10; PinHeader_1x06_P2.54mm_Vertical
J3: ADS1115 10-PIN; PinSocket_1x10_P2.54mm_Vertical

Connections:
/A0: J1.5, J3.7
/A1: J1.4, J3.8
/A2: J1.3, J3.9
/A3: J1.2, J3.10
/ADDR: J2.5, J3.5
/ALRT: J2.6, J3.6
/GND: J2.2, J3.2
/SCL: J2.3, J3.3
/SDA: J2.4, J3.4
/VDD: J2.1, J3.1

Notes on the sheet:
ADS1115 ADAPTER
Lets a 10-pin inline ADS1115 board (older Adafruit 1085 and most clones) plug into the breakout board's
two-row ADS1115 sockets (rev 2.8: J15 + J10). Straight-through wiring: same signals, same address (0x48,
ADDR is grounded on the breakout board), no software change. A+ / A- of the two-row pattern are not used.
J1 and J2 are male pins underneath. J3 is the socket on top. Crossing wires without a dot are not joined.
H1-H4: M2.5, line up with the breakout board's H5-H8: screw the adapter down on 11 mm standoffs.
H5-H6: M2.5, the 10-pin board's own holes (original Adafruit layout): screw it down too.

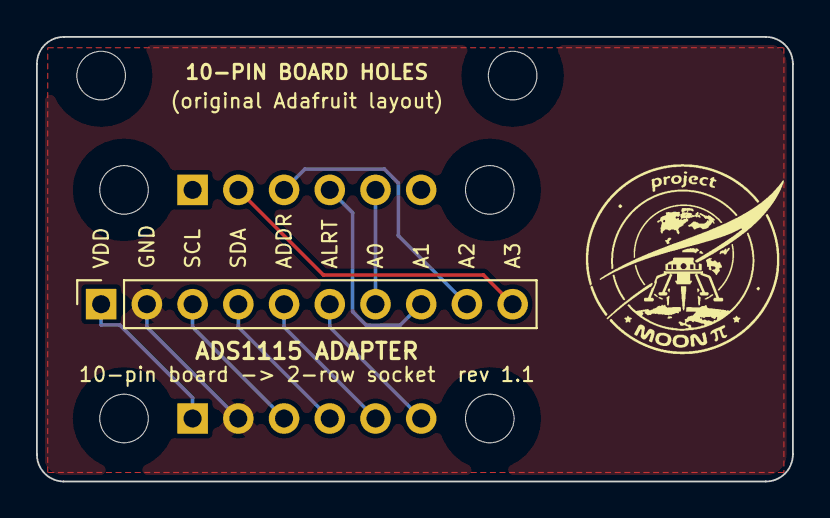
[picture p31: board ads1115-adapter.kicad_pcb from above]

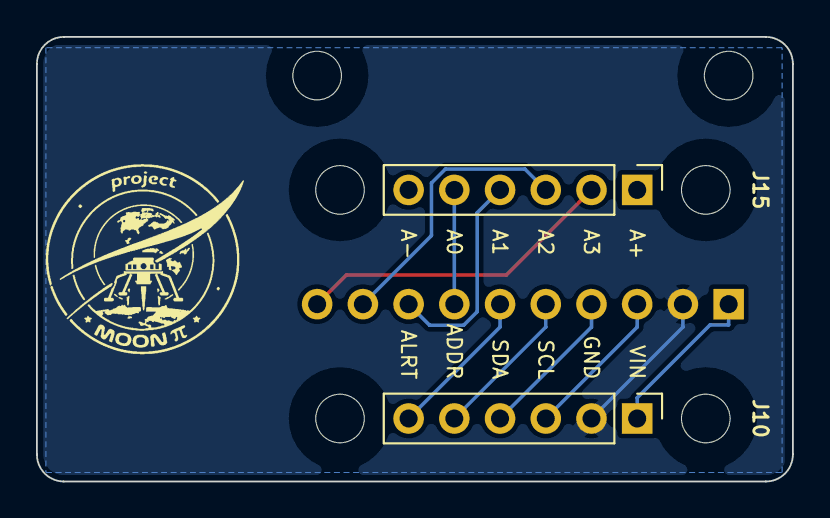
[picture p32: board ads1115-adapter.kicad_pcb from below]

Board: 2 copper layers, 42.0 x 24.7 mm, 9 parts (2 on the bottom side), 10 nets.
