ricsne2010/bobcat-dash/version.py

"""Software version, shown under the splash picture and in a corner of the dash.

Change it with  python3 tools/bump_version.py 1.1.0  (sets BUILD_DATE to today as well),
then remake the boot splash picture (README: Monitor and boot splash) so it shows the new number.
"""
VERSION = "1.0.0"
BUILD_DATE = "2026-10-22"
BOARD_REV = "2.9"          # the breakout board this software is made for (breakout-board/README.md)
SOURCE = "github.com/ricsne2010/bobcat-dash"
