ricsne2010/bobcat-dash/(commit log)

2026-10-23 Bobcat M700 digital dash: software, breakout board rev 2.4, docs
    Raspberry Pi + pygame dash for a 1978 Bobcat M700 (Wisconsin VH4D, PerTronix ignition):
    tach from the ignition coil, battery/charging, fuel, oil and hydraulic warnings, hour meter,
    key-off shutdown, light sensing, cranking/starter-rest logic, cool-down and Pi health warnings,
    with a full simulator. Includes the KiCad breakout board (rev 2.4, generated from design.py),
    fab files, wiring diagrams and the BOM.
    [board-bom.csv, bobcat-dash-BOM.xlsx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]
2026-10-23 Machine angle display, safe tilt zeroing, board rev 2.6 (latching TILT connector)
    Software:
    - Machine angle panel: roll (rear view) and pitch (side view) skid steer outlines that tilt with
    the machine, with amber/red limits (roll 8/15 deg, nose up 15/20, nose down 20/25; not Bobcat
    figures). Battery and fuel share one panel; warning tiles shorter. [tilt] enabled = false restores
    the original layout.
    - tilt.py: LSM6DSOX reader with gyro/accelerometer blending (bumps move it < 1 deg), start-up
    averaging so a restart on a slope reads the true angle at once, and --zero-tilt that refuses on a
    slope (> 5 deg) or while moving unless --force.
    - Simulator: Left/Right roll, , / . pitch, 0 le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
    [board-bom.csv, bobcat-dash-BOM.xlsx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]
2026-10-23 TILT connector 3D model: use Molex's STEP (kept local), re-render board pictures
    - gen_pcb.py and the board file point J13 at ${KIPRJMOD}/3d/436500415.stp, rotated and offset so the
    pins sit in the pads (checked from below), the housing on the board and the latch at the notch.
    - breakout-board/kicad/3d/ is git-ignored (Molex's terms); the board README says where to download it.
    - board-top.png and board-3d.png now show the real Micro-Fit connector.
    [bobcat-dash-breakout.kicad_pcb]
2026-10-23 Temperatures, tilt sensor fault handling, board rev 2.7, drilling template
    - Board rev 2.7 (162 x 134 mm): on-board DS18B20 box-air sensor (U11) and a
    latching Micro-Fit 3-pin TEMP PROBE header (J14) on the 1-Wire bus (GPIO 4)
    - Dash: BOX HOT warning (50/65 C, 2 C hysteresis) and ambient readout for
    cab/outside probes (each or averaged); --temps lists the sensors
    - Tilt sensor fault handling: missing/dead/nonsense sensor shows "--" instead
    of a made-up angle, re-initialises on its own, logs once
    - Simulator: '-' unplugs the tilt sensor, '=' steps the box temperature
    - Printable 1:1 drilling template (breakout-board/docs/mounting-template.pdf)
    with check rulers and Actual-size print p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
    [board-bom.csv, bobcat-dash-BOM.xlsx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]
2026-10-23 TEMP PROBE connector 3D model aligned; board pictures show both Molex plugs
    Molex's 43650-0315 STEP has its origin in a different place from the 4-pin
    part, so J14 gets its own offset (0, 0.2, 9.9). Re-rendered docs pictures.
    The STEP files stay local (gitignored).
    [bobcat-dash-breakout.kicad_pcb]
2026-10-23 Board rev 2.8: two-row ADS1115, mono/stereo amp sites, 162 x 159 mm; ADS1115 adapter
    Breakout board rev 2.8:
    - ADS1115 (Adafruit 1085, STEMMA QT) plugs straight in: J10 + J15, two 6-pin
    rows 12.7 mm apart, with M2.5 standoff holes H5-H8
    - Amp: mono board (Adafruit 3006) on J9 with standoff holes H9-H10, or the
    stereo board (Adafruit 6513) on new J16 with corner holes H11-H14. Same
    I2S signals, fit one only
    - Board 25 mm taller (162 x 159 mm): new top strip for the stereo site, the
    title and the Project Moon Pi logo (now on top). Top mounting holes moved:
    153 x 137.5 mm; drilling template updated
    - Freerouting output logged to out/route.log (headless: its GUI mode never
    saves the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
    [ads1115-adapter-B_Cu.gbl, ads1115-adapter-B_Mask.gbs, ads1115-adapter-B_Silkscreen.gbo, ads1115-adapter-Edge_Cuts.gm1, ads1115-adapter-F_Cu.gtl, ads1115-adapter-F_Mask.gts, ads1115-adapter-F_Silkscreen.gto, ads1115-adapter-NPTH.drl]
2026-10-23 Bigger logo on the breakout board; ADS1115 adapter rev 1.1 (module holes)
    - Breakout board: Project Moon Pi logo 18 -> 26 mm in the top strip (silkscreen
    only, routing unchanged); Gerbers and pictures updated
    - ADS1115 adapter rev 1.1: 5 mm taller (42 x 24.7 mm) with M2.5 holes H5/H6 for
    the 10-pin board's own mounting holes (original Adafruit layout), labelled on
    the silkscreen; README fitting order and parts list updated
    [ads1115-adapter-B_Cu.gbl, ads1115-adapter-B_Mask.gbs, ads1115-adapter-B_Silkscreen.gbo, ads1115-adapter-Edge_Cuts.gm1, ads1115-adapter-F_Cu.gtl, ads1115-adapter-F_Mask.gts, ads1115-adapter-F_Silkscreen.gto, ads1115-adapter-NPTH.drl]
2026-10-23 Board rev 2.8 re-layout: ribbon header on the top edge, amps side by side, 9 mounting holes, standoff keepouts
    - Pi ribbon header J1 and the power LEDs move to the top edge (ribbon goes
    straight up to the lid); TILT plug to the top-left corner
    - Stereo amp site J16 now sits beside the mono amp J9 ("fit one amp only")
    - 9 M3 mounting holes against vibration: corners, mid-sides (H15-H18) and
    one near the centre (H19); drilling template updated
    - Copper-free rings around every hole on both sides (M3 r 4 mm, M2.5 r 3 mm,
    extended to nearby edges): brass standoffs need no insulating washers and
    never tie board ground to the box
    - ADS1115 adapter: same standoff keepouts
    - README, parts lis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
    [ads1115-adapter-B_Cu.gbl, ads1115-adapter-B_Mask.gbs, ads1115-adapter-B_Silkscreen.gbo, ads1115-adapter-Edge_Cuts.gm1, ads1115-adapter-F_Cu.gtl, ads1115-adapter-F_Mask.gts, ads1115-adapter-F_Silkscreen.gto, ads1115-adapter-NPTH.drl]
2026-10-23 Key-off backstop: power off 30 s after key-off if the dash isn't running
    tools/bobcat-dash-keywatch (+ systemd service) watches the KEY input (GPIO 6)
    on its own. If the key has been off for 30 s and the Pi is still up (the dash
    crashed or isn't running), it runs a clean systemctl poweroff, so the SD card
    is protected. It only acts after seeing the key on once, so a board without
    the power-hold circuit never shuts the Pi down. The dash's own 5 s countdown
    (with cancel) is unchanged; the board's 3-minute timer remains the last resort.
    README: install steps and key-off safety nets updated.
2026-10-23 One-command Pi setup script (tools/setup-pi.sh) and SD card backup notes
    Flash Raspberry Pi OS Lite with Raspberry Pi Imager (user, Wi-Fi, SSH), clone
    the repo, run sudo bash bobcat-dash/tools/setup-pi.sh , reboot. It does every
    install step: packages, I2C, 1-Wire, MAX98357A overlay, forced HDMI mode, boot
    splash, the dash service (for any username), and the key-off shutdown pieces
    (HOLD, KILL hook, sudoers, keywatch backstop). Re-runnable; options
    --fast-boot, --resolution WxH, --no-power-hold.
    README: quick setup section and how to back up the finished card as an image.
2026-10-24 S.S.O.M.S: menu screens, service reminders, service Wi-Fi web page, USB stick, board rev 2.9, button pod
    Dash (now S.S.O.M.S, System Status, Operations, and Maintenance System; Bobcat M700):
    - Menu buttons and screens: HISTORY (clear one / all, ALL ALARMS archive), SERVICE (Bobcat 700 schedule,
    climate setting, details, mark done), SYSTEM; alarms lock the menus until SILENCE; pod fan control.
    - Service Wi-Fi (SYSTEM > OK): hotspot + built-in web page (status, performance reports, alarms, service,
    downloads, software update / go back); 30 min countdown, EXTEND on the web page, off at key-off;
    connected devices shown on the dash.
    - Usage recording for the reports: full throttle / part th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
    [board-bom.csv, bobcat-dash-BOM.xlsx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]
2026-10-24 M.O.S.S. rename, settings, B612 font, board rev 2.9 layout (blue, 0.6 mm supplies)
    - System renamed M.O.S.S. (Maintenance, Operations, and Service System);
    Wi-Fi SSID and USB folder MOSS-BOBCAT-M700
    - Maintenance code: lockout, recovery code, SD-card reset; gates clears,
    mark done, clock, Wi-Fi, USB and web install/restore/restart;
    "are you sure?" pop-ups default to NO
    - Settings: C/F units, 12h/24h clock, set clock (device sync / by hand on
    web or dash), named time zone with automatic DST
    - Web: status tiles (engine status links to service/alarms), Wi-Fi EXTEND,
    reports with daily temp/battery charts, extremes with time, paged day
    table, throttle bands reframed; alarm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
    [ads1115-adapter-B_Cu.gbl, ads1115-adapter-B_Mask.gbs, ads1115-adapter-B_Silkscreen.gbo, ads1115-adapter-Edge_Cuts.gm1, ads1115-adapter-F_Cu.gtl, ads1115-adapter-F_Mask.gts, ads1115-adapter-F_Silkscreen.gto, ads1115-adapter-NPTH.drl]
2026-10-24 ECAM dark theme with light/dark switch, extremes table, MX code change, MX UNLOCKED frame
    Web:
    - Dark look modelled on the Airbus ECAM (black, cyan labels, green normal
    values, amber caution, red warning, white underlined titles)
    - LIGHT / DARK button on every page and Settings > Look of these pages
    (same as device / light / dark), remembered per phone or laptop
    - Reports > Extremes: lowest and highest of each sensor side by side, with
    date and time, centred
    Recording:
    - Lows and highs for every sensor: E-box and Pi CPU lows added, each probe
    (cabin, outside...) kept on its own instead of lumped together
    Dash:
    - SYSTEM > MX CODE: change the maintenance code (old code first, a
    "ch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
2026-10-24 Logo on the dash and web, SYSTEM > ABOUT, board rev 2.9 final (bigger logo, fun back)
    - Project Moon Pi patch in the header (splash/logo-small.png)
    - SYSTEM > ABOUT: patch, system name, software version, board rev,
    computer model, engine hours, Wi-Fi name, source and font credit
    - Patch in every page header (/logo/...), embedded in exported reports
    - Software page opens with an About section
    Board rev 2.9:
    - Logo 30 mm (was 26) and further left, title block beside it
    - Back silkscreen: fun lines and the dash's skid steer climbing a hill
    - Routed, DRC and schematic parity clean; gerbers, BOM, renders updated
    Tools: tools/make_logo.py makes the transparent logo pictures
    Co-Aut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
    [bobcat-dash-breakout-B_Cu.gbl, bobcat-dash-breakout-B_Mask.gbs, bobcat-dash-breakout-B_Silkscreen.gbo, bobcat-dash-breakout-Edge_Cuts.gm1, bobcat-dash-breakout-F_Cu.gtl, bobcat-dash-breakout-F_Mask.gts, bobcat-dash-breakout-F_Silkscreen.gto, bobcat-dash-breakout-NPTH.drl]
2026-10-24 Rev 3.0: cylinder head temps (CHT) and parking brake; new CHT + Parking Brake board
    - cht.py: MCP9601 thermocouple amplifiers on I2C, per-cylinder limits
    (500 F warn, 550 F alarm + horn; factory head switches trip over 570 F),
    spread check vs the other cylinders' average, NO SIGNAL per cylinder.
    M.O.S.S. warns only, never stops the engine
    - brake.py: (P) BRAKE tell-tale, PARKING BRAKE ON when working above idle
    with it set, SET PARKING BRAKE reminder at key-off
    - Dash CYL HEAD TEMP tile, web Status tiles, Engine Status, alarm history,
    per-cylinder daily highs/lows in Reports; simulator keys ` and /
    - [cht] and [park_brake] in config.toml (off until the hardware is fitted)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
    [board-bom.csv, bobcat-dash-BOM.xlsx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]
2026-10-24 Web Configuration page: switch installed equipment on or off
    - New /configuration page (top menu): cylinder head temps and each cylinder
    1-4 on its own (e.g. only cylinder 4), hydraulic filter / oil temp switches,
    parking brake, machine angle, light sensing and each light, horn,
    temperature sensors, pod fan
    - Saving needs the engine stopped and the maintenance code, is logged in
    the alarm history, and restarts the dash; choices live in settings.json
    over config.toml (survive updates, no file editing or SSH)
    - The dash and simulator follow the choices: tiles for parts switched off
    disappear and the rest re-space
